PlanetxGear/KT0913_FM_Radio/LTSpice/Filter_003_WS001544.JPG

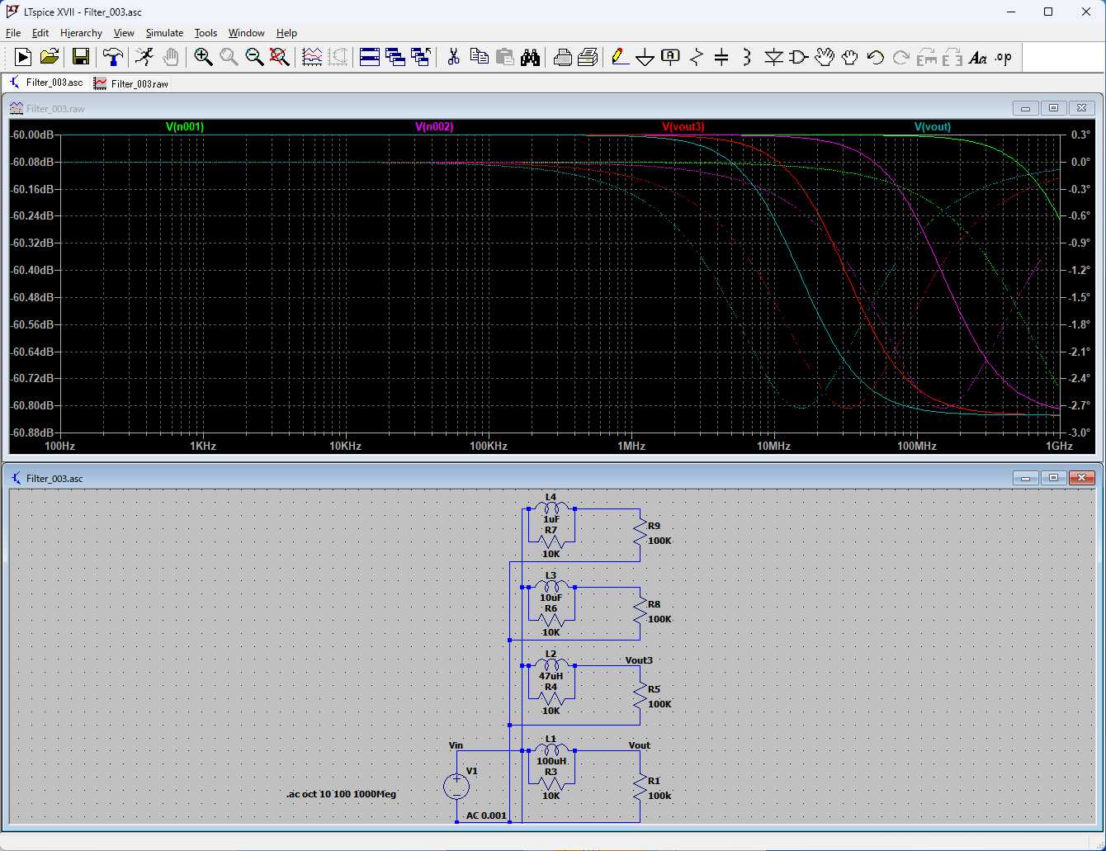
LTSpice/Filter_003_WS001544.JPG
