PlanetxGear/KT0913_FM_Radio/LTSpice/イヤホンアンテナ_LTSpice_WS001533.JPG

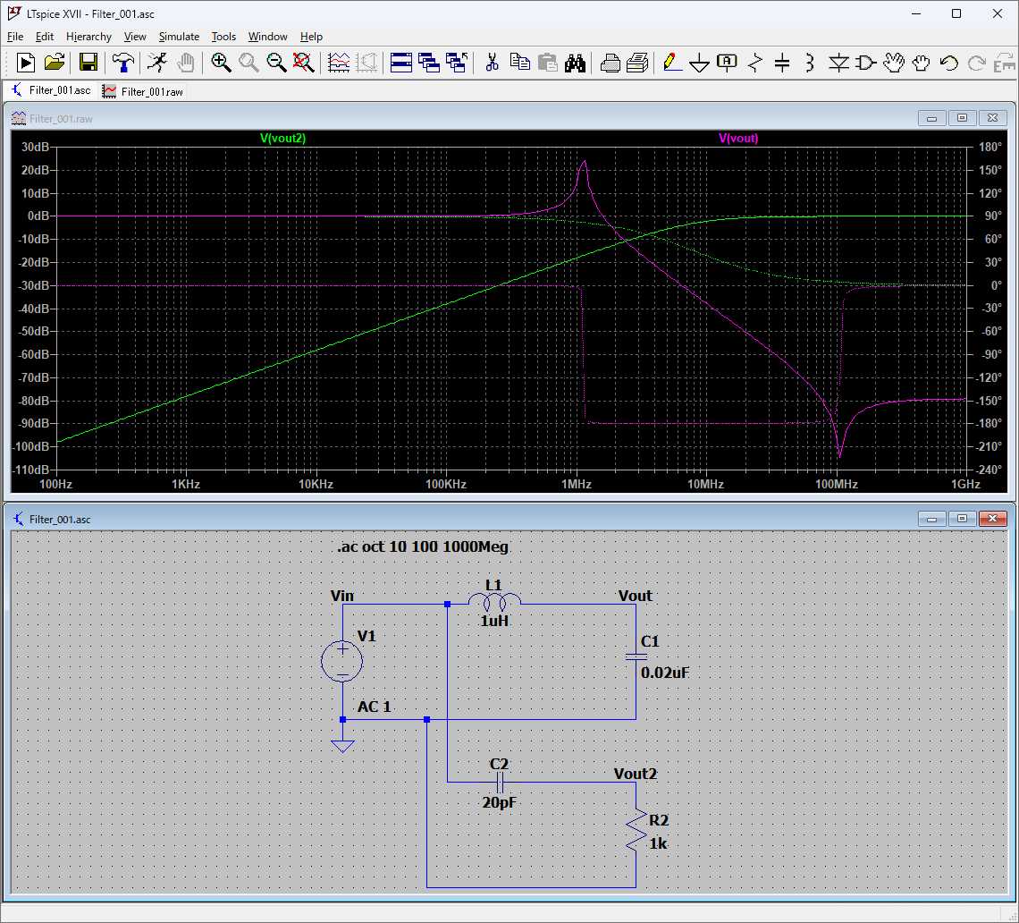
LTSpice/イヤホンアンテナ_LTSpice_WS001533.JPG
