PlanetxGear/KT0913_FM_Radio/PICクラブ発表資料_KT0913ラジオ_20240126.pdf

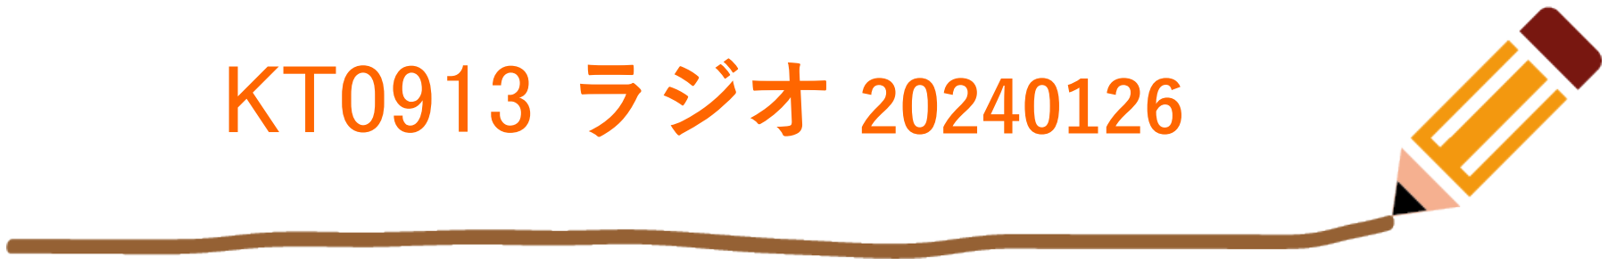
[picture p3: figure]
ラジオ 20240126

村上ひろし PlanetxGear
2024/01/26

KT0913 ラジオについて

- 2023年8月に後閑先生が発表されていた、DSP FM ラジオが面 白そうでしたので、自分でも作成してみました。
- KT0913は（株）秋月電子通商で購入できる、デジタルAM/FM ラジオICです。
– SDR方式のラジオ受信用IC
– FMは32～110MHz、AMは500～1710kHzに対応
– 16ピンSSOP, 0.635mmピッチ

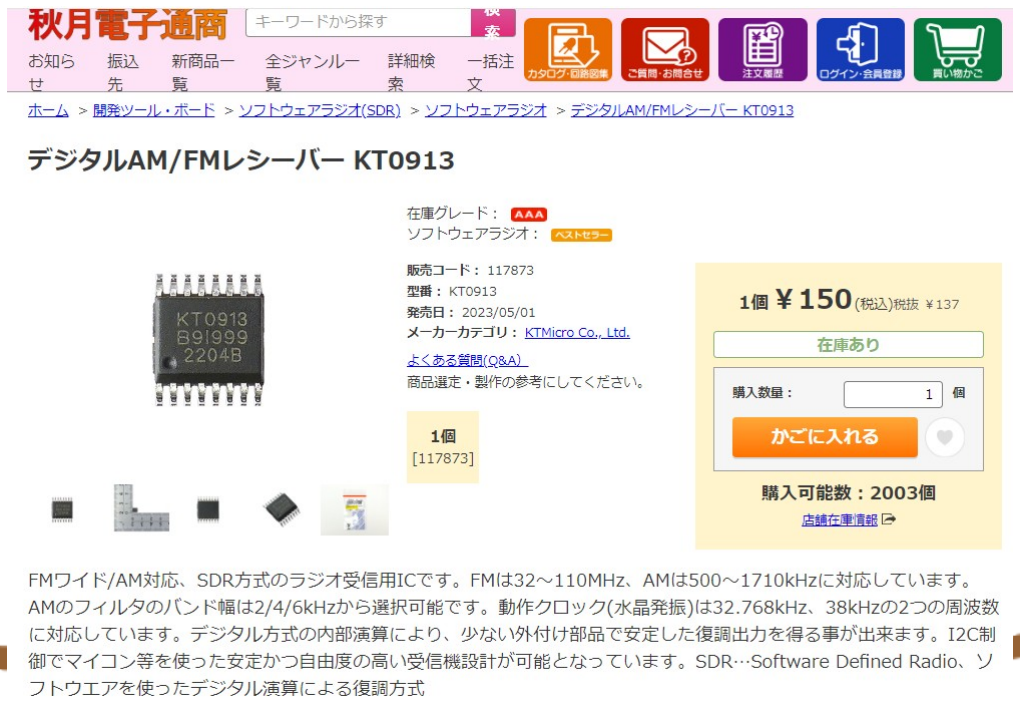
[picture p4: figure]

後閑先生のラジオの構成１

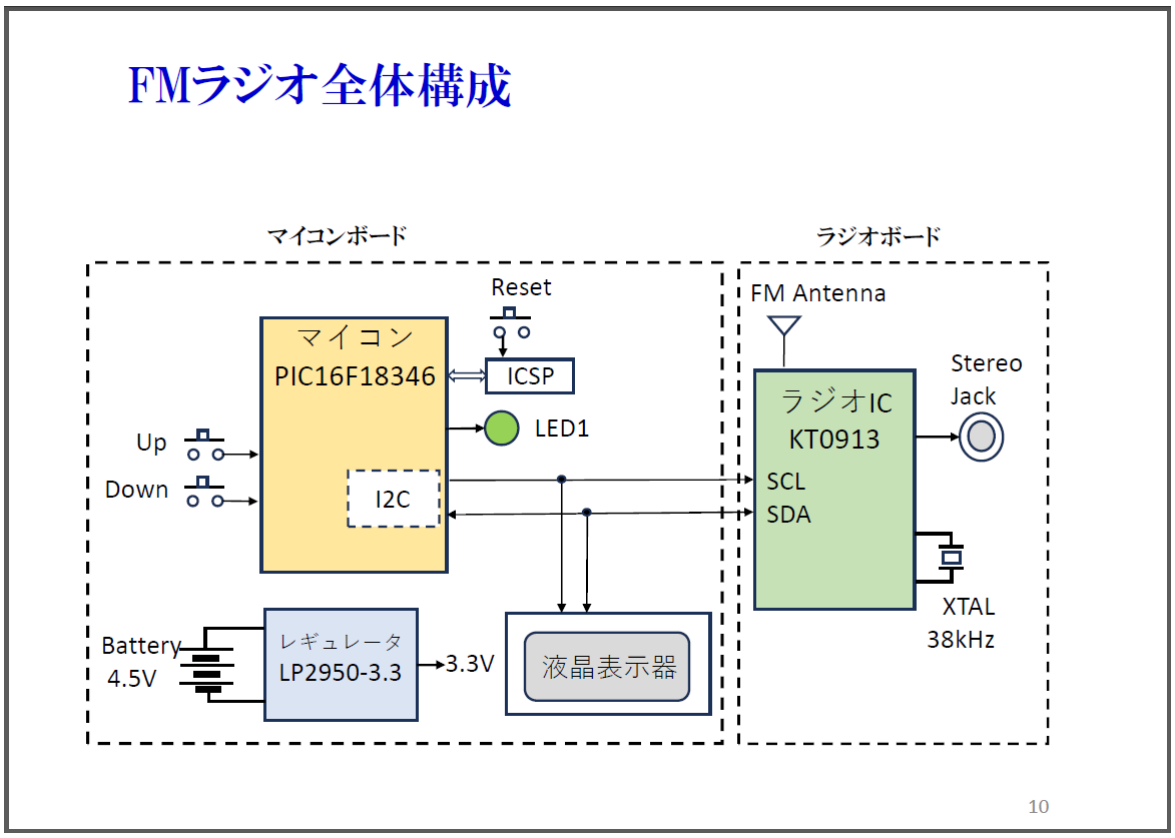
[picture p5: figure]

後閑先生のラジオの構成２

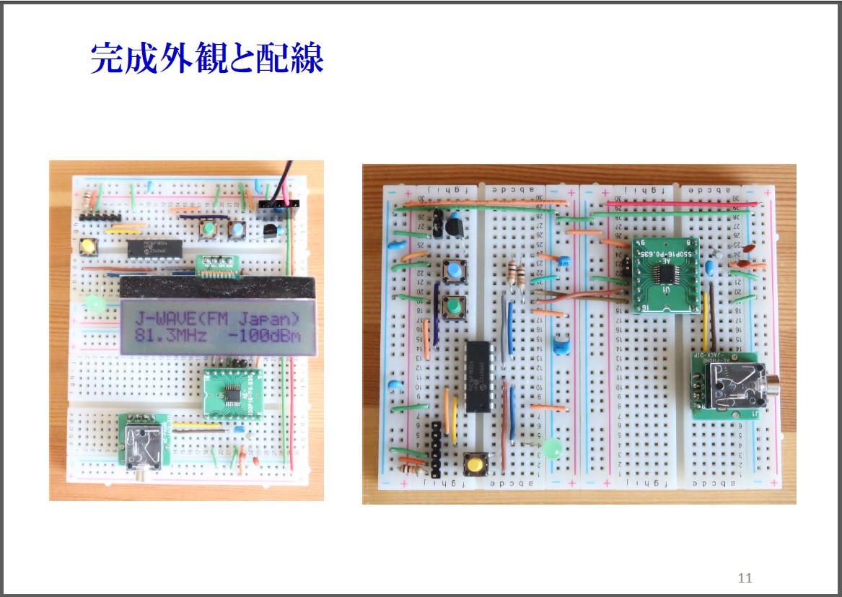
[picture p6: figure]
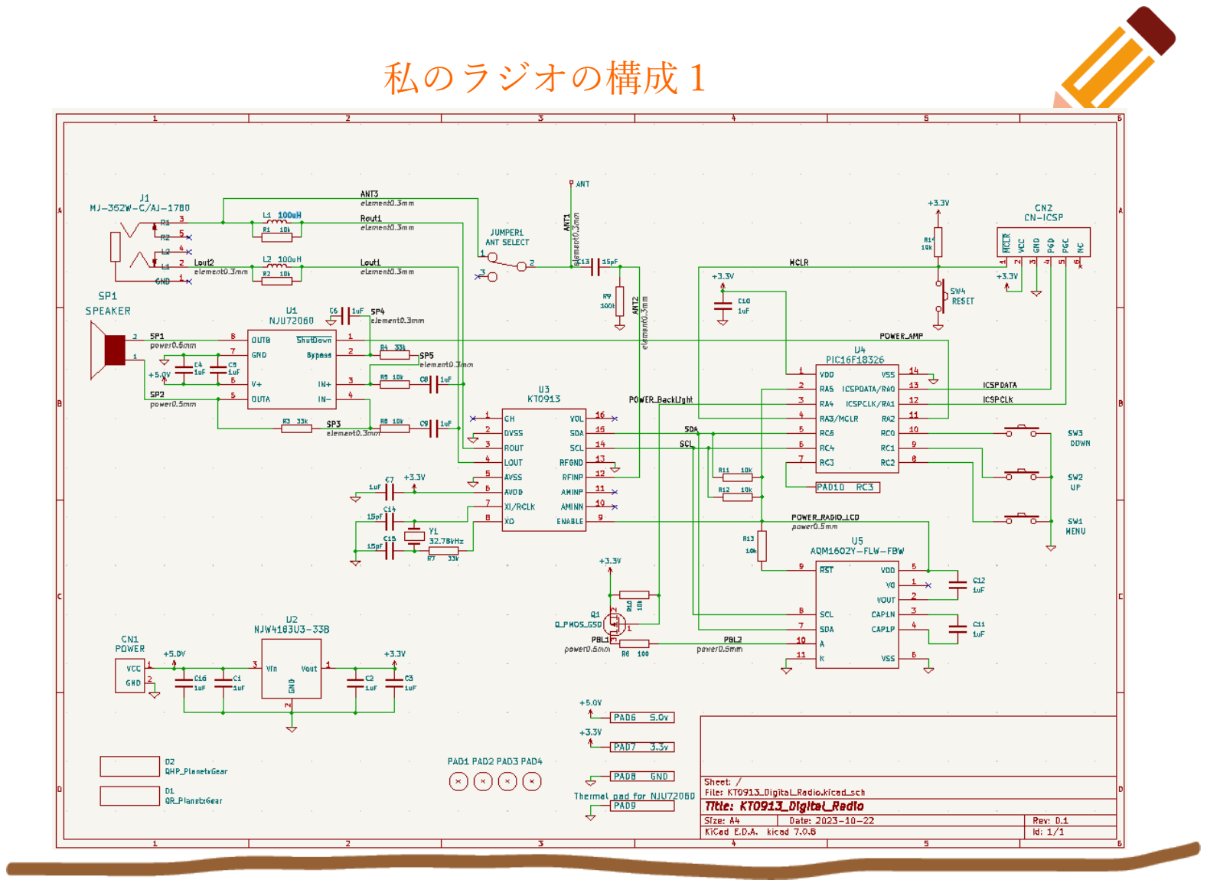
[picture p7: page 5]

私のラジオの構成１

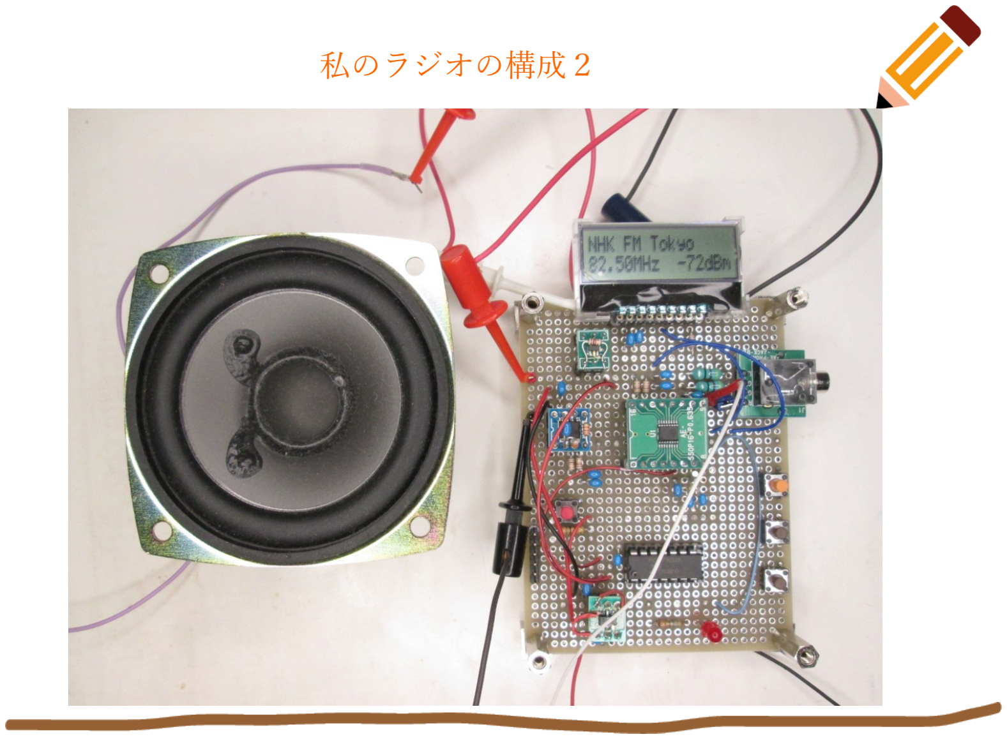
[picture p8: page 6]

私のラジオの構成２

ポイント１

- モノラル出力。
- ボリュームの調整はソフトウェア。*1~31段階
- 電源スチッチ代わりにスリープモードを搭載。*150μA
- イヤホンコードがアンテナ代わりに出来る。
– 渡辺さん、大江さんありがとうございます。

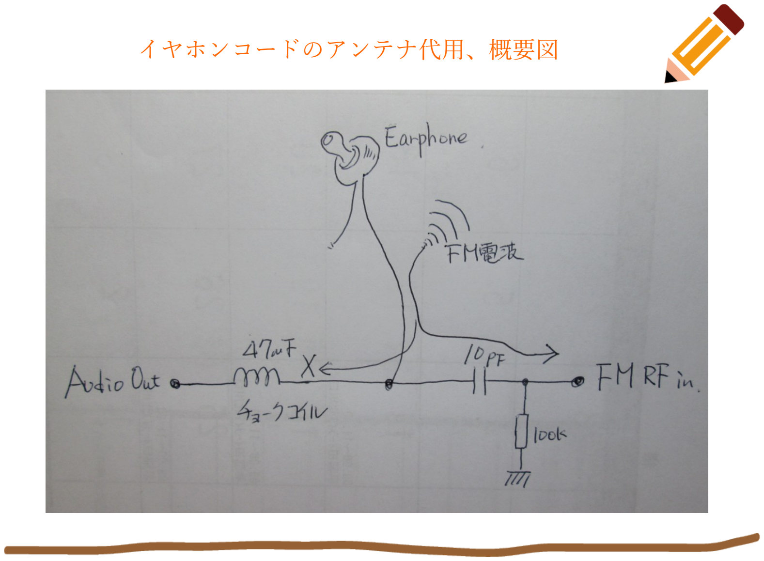
[picture p9: page 8]

イヤホンコードのアンテナ代用、概要図

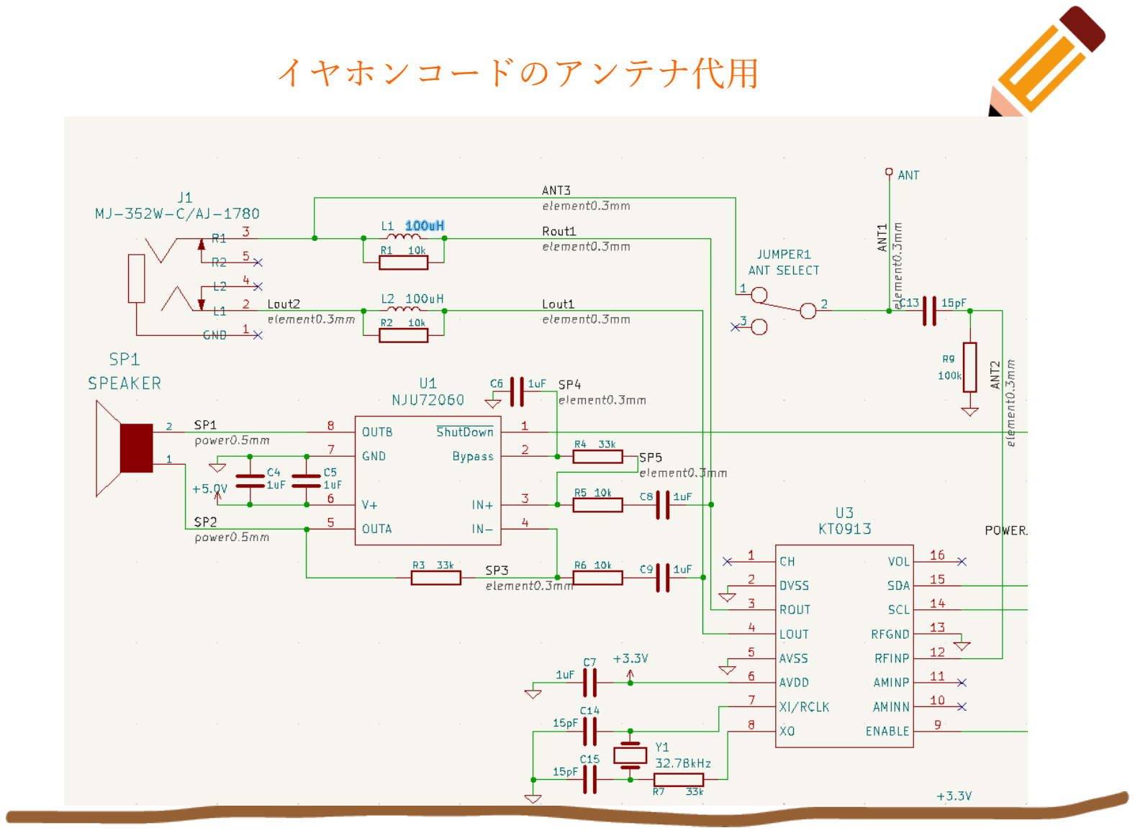
[picture p10: page 9]

イヤホンコードのアンテナ代用

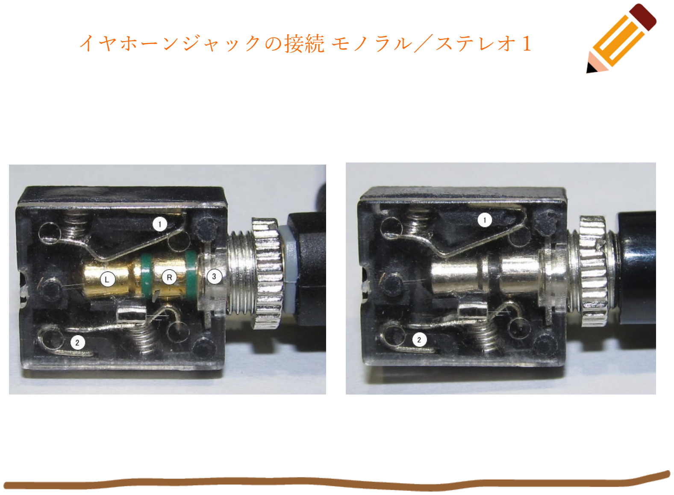
[picture p11: page 10]

イヤホーンジャックの接続 モノラル／ステレオ１

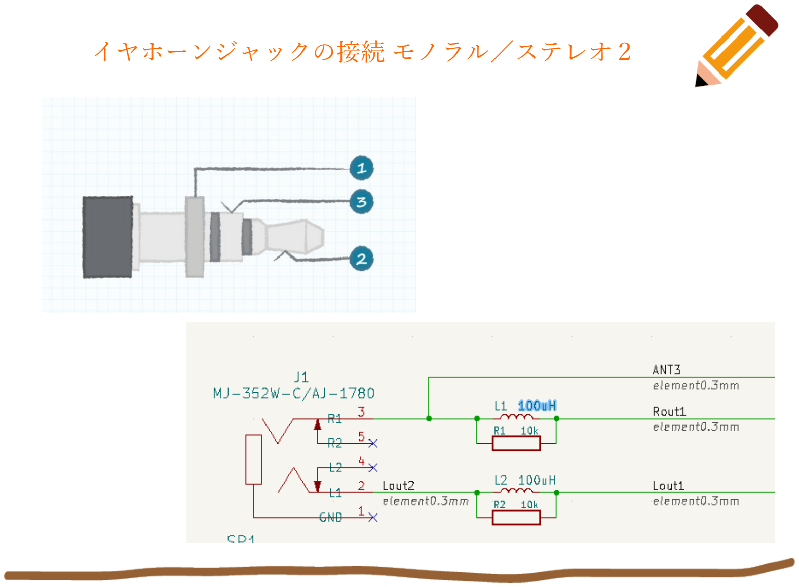
[picture p12: page 11]

イヤホーンジャックの接続 モノラル／ステレオ２

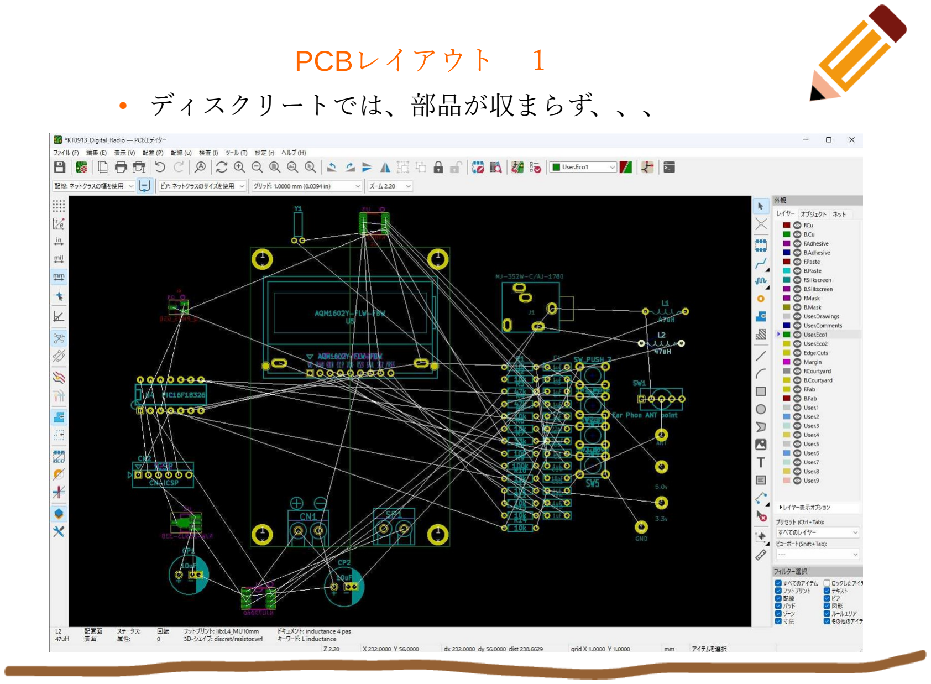
[picture p13: page 12]

PCBレイアウト　１
- ディスクリートでは、部品が収まらず、、、

PCBレイアウト　２
- 1608のチップ抵抗とチップコンデンサに変更して何とか収まりました。

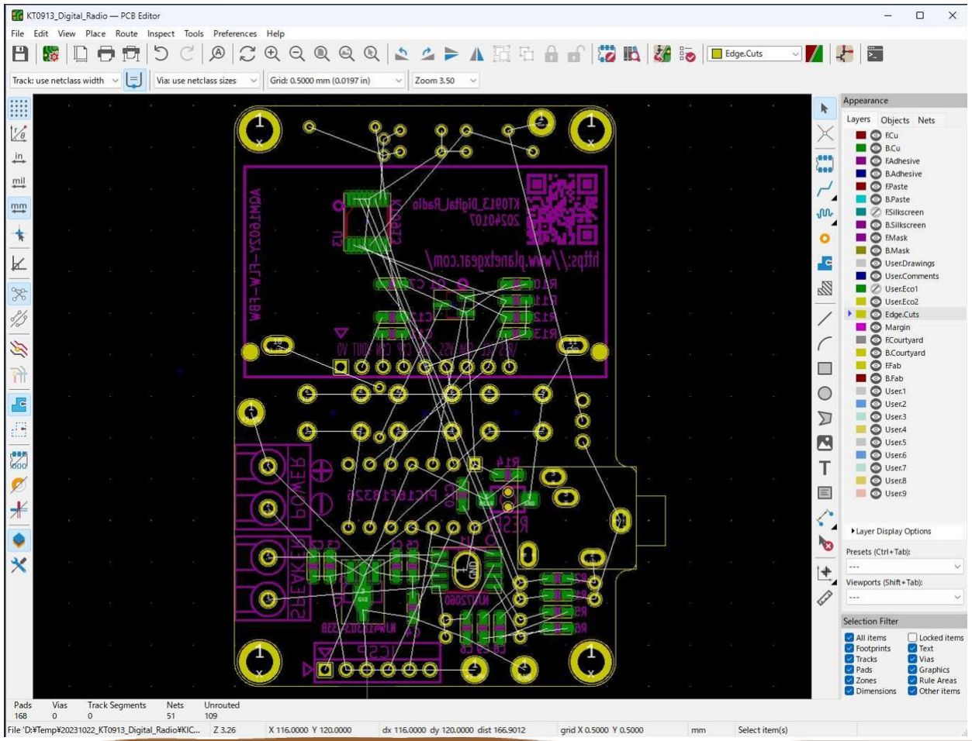
[picture p14: figure]

PCBレイアウト　３

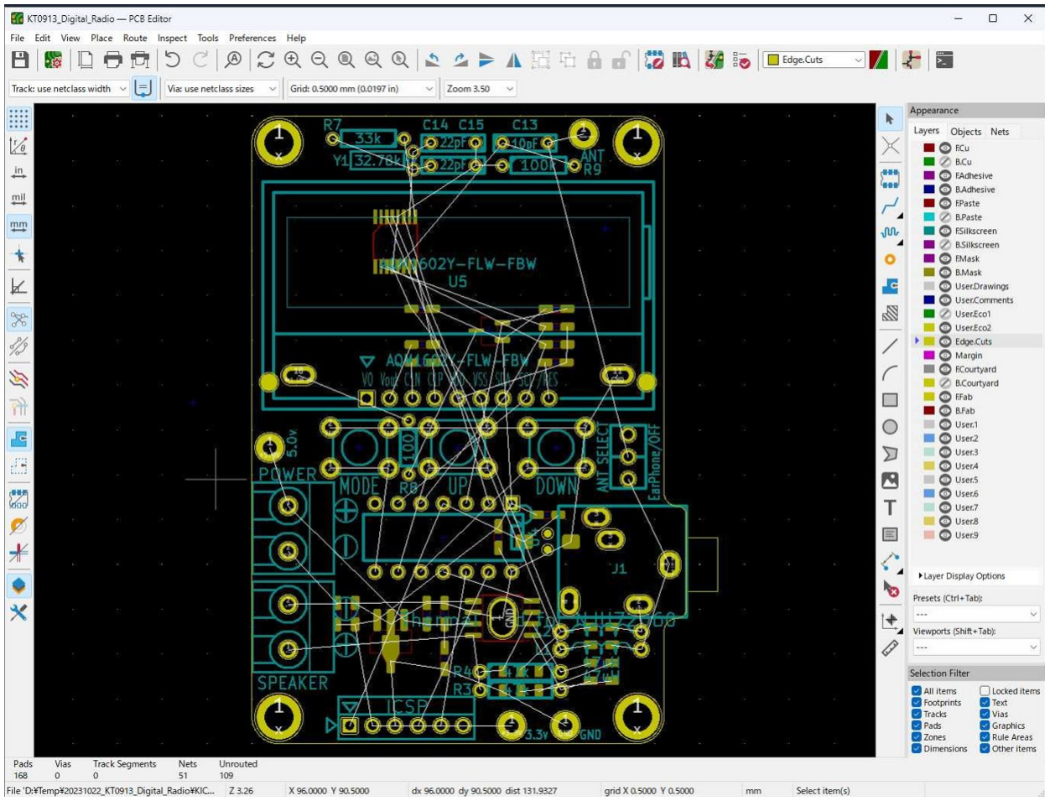
[picture p15: figure]

PCBレイアウト　３
- 今回自動配線は使わず、全て手配線で引きました。

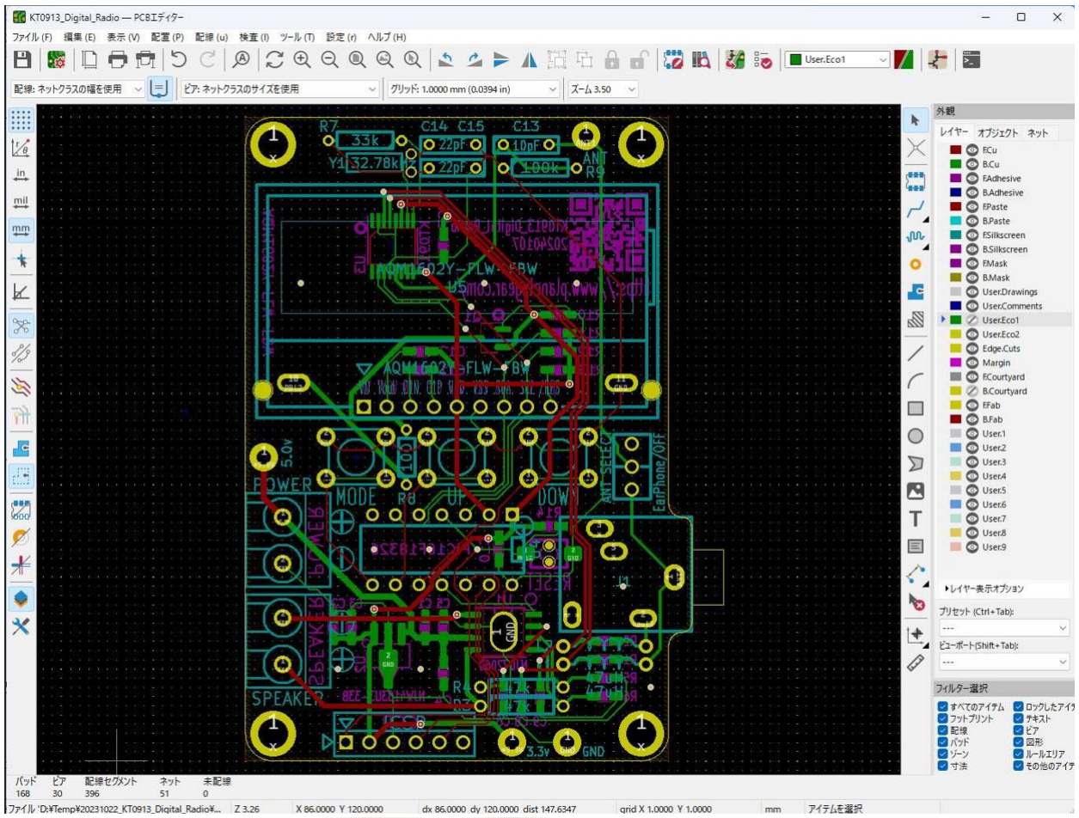
[picture p16: figure]
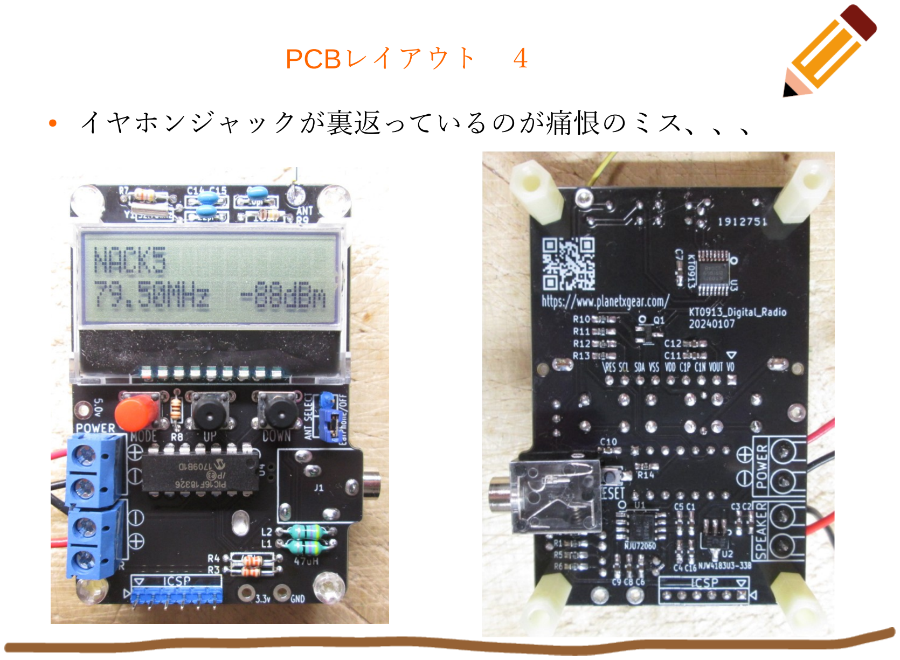
[picture p17: page 16]

PCBレイアウト　４

- イヤホンジャックが裏返っているのが痛恨のミス、、、

### Thank you!

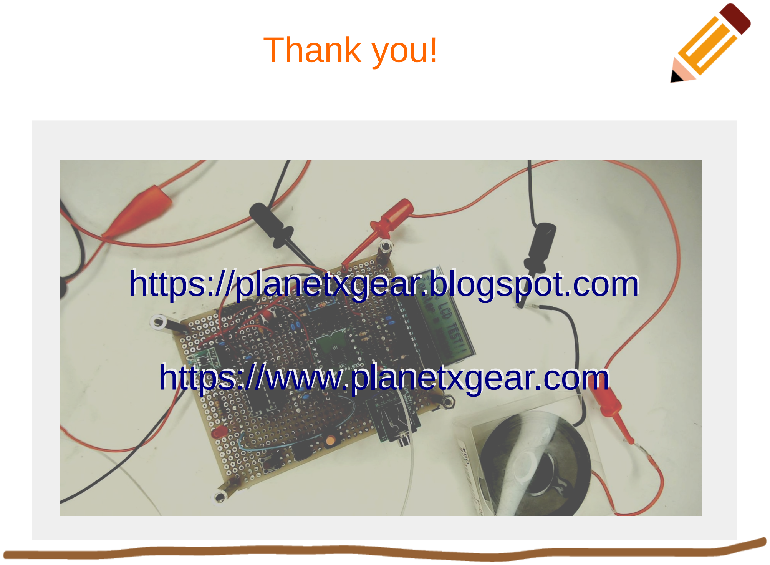
[picture p18: page 17]

### https://planetxgear.blogspot.com

### https://www.planetxgear.com
