PlanetxGear/KT0913_FM_Radio/LTSpice/1uH-0.1uF_WS001536.JPG

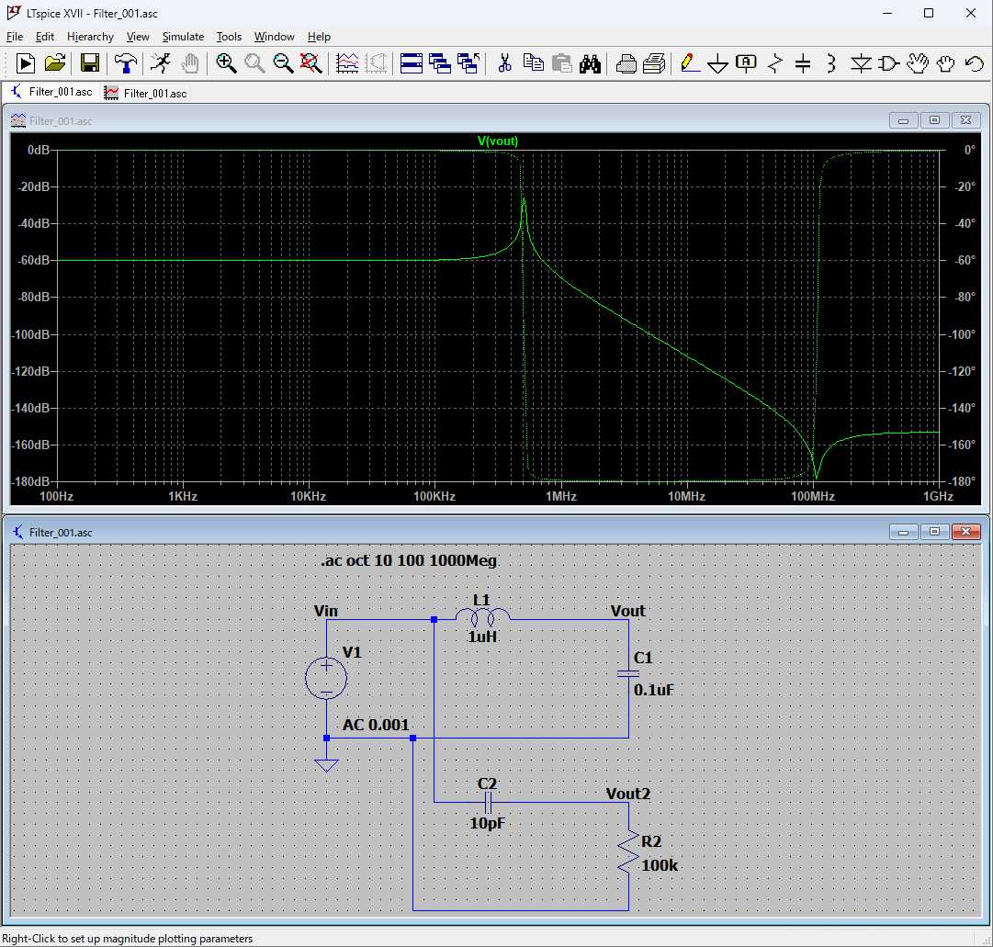
LTSpice/1uH-0.1uF_WS001536.JPG
