PlanetxGear/KT0913_FM_Radio/LTSpice/47uH-0.1uF_WS001534.JPG

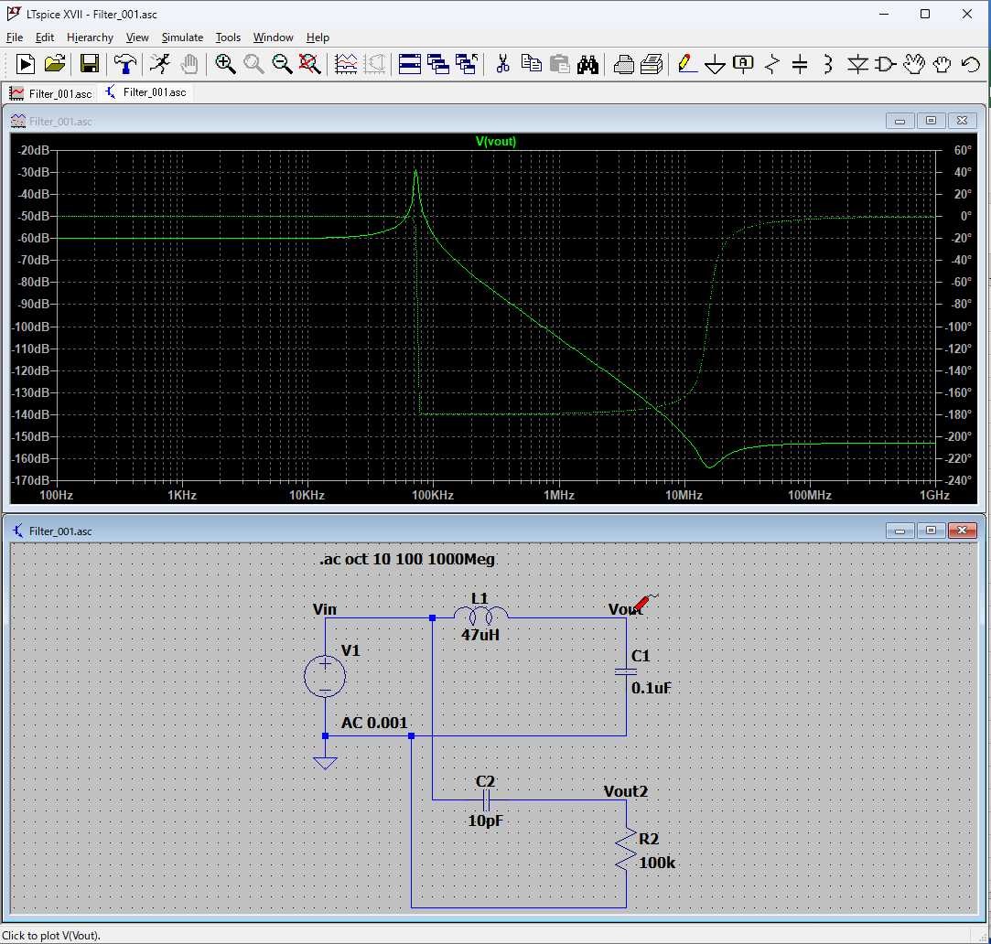
LTSpice/47uH-0.1uF_WS001534.JPG
