PlanetxGear/KT0913_FM_Radio/LTSpice/Filter_002_WS001537.JPG

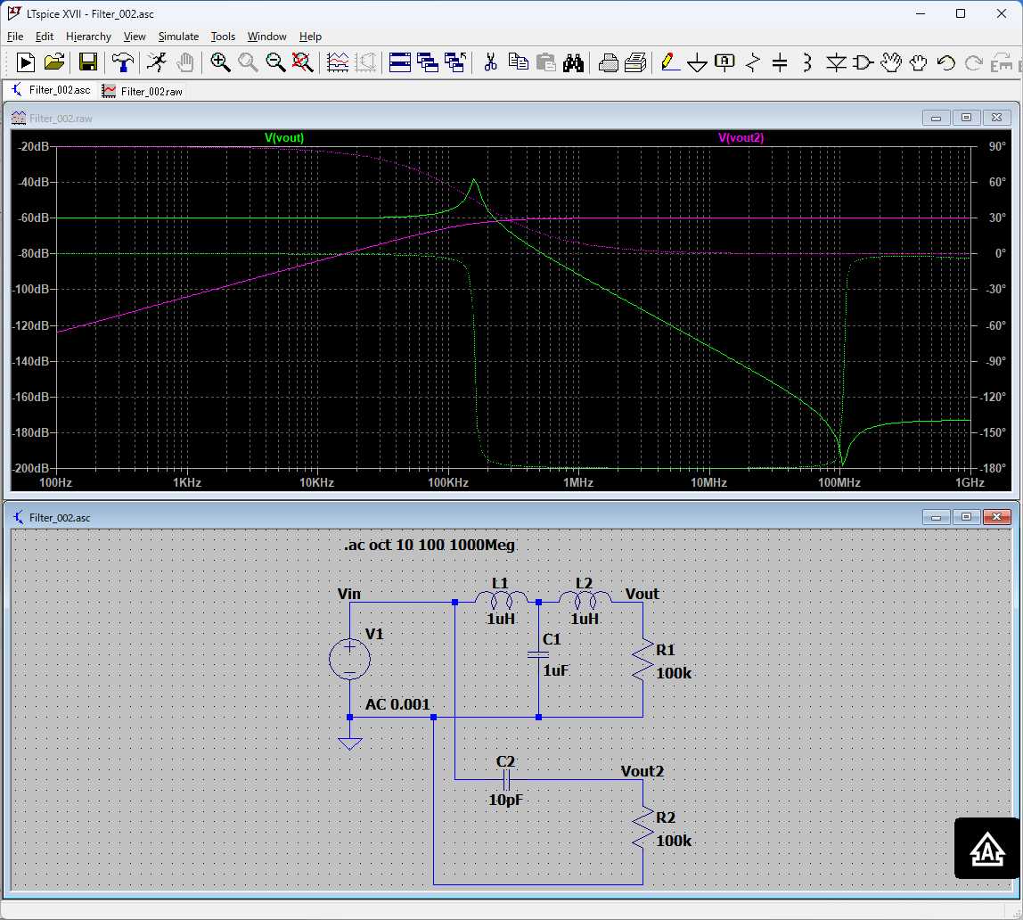
LTSpice/Filter_002_WS001537.JPG
