PlanetxGear/KT0913_FM_Radio/LTSpice/WS001540.JPG

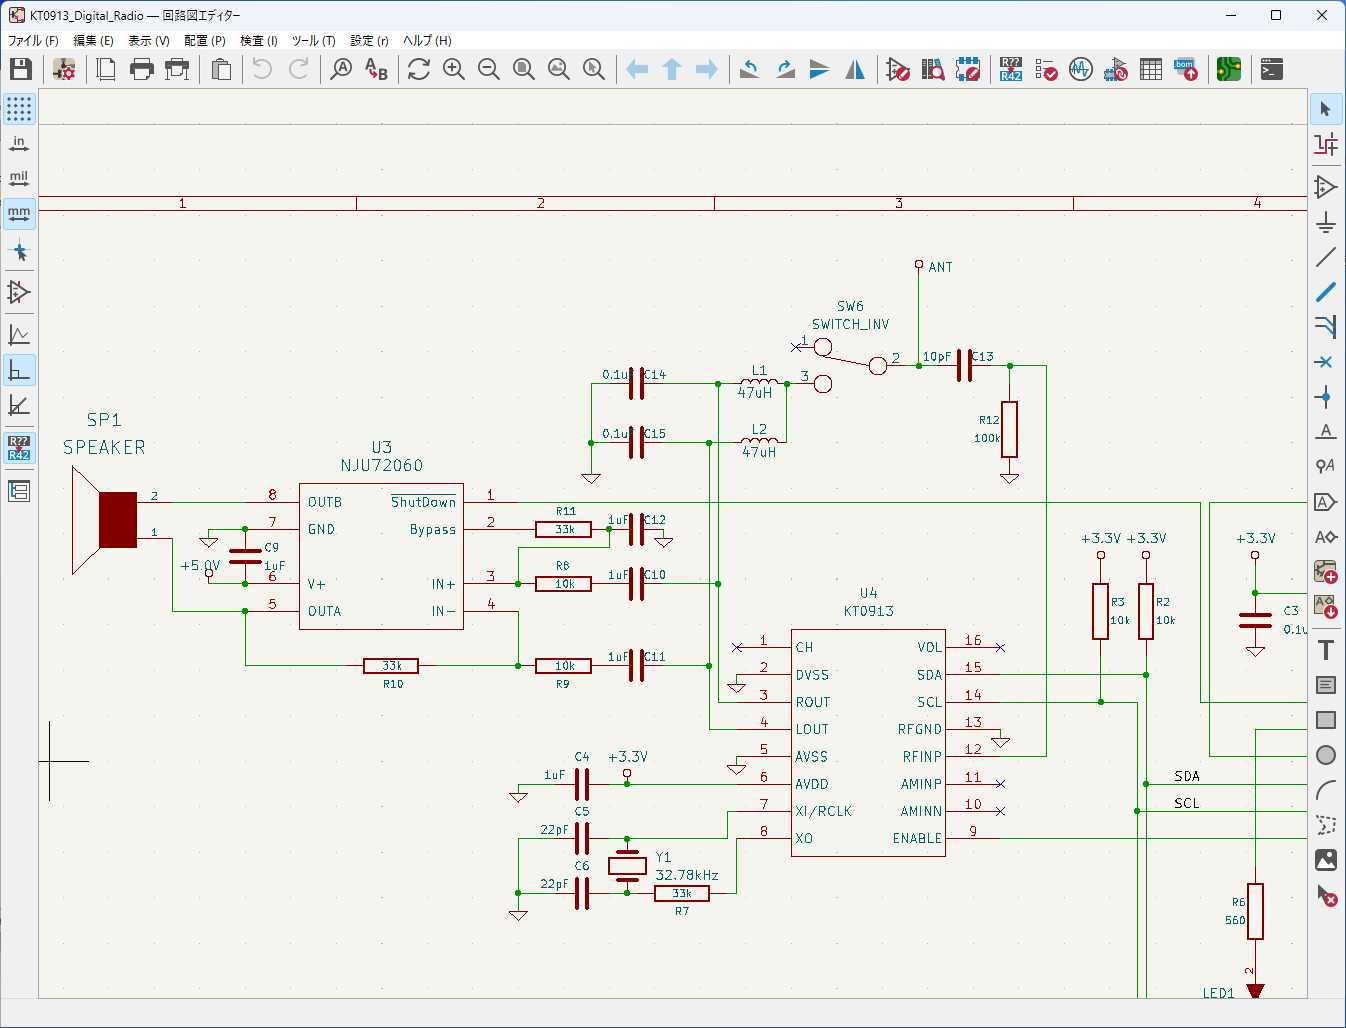
LTSpice/WS001540.JPG
