PlanetxGear/KT0913_FM_Radio/LTSpice/WS001541.JPG

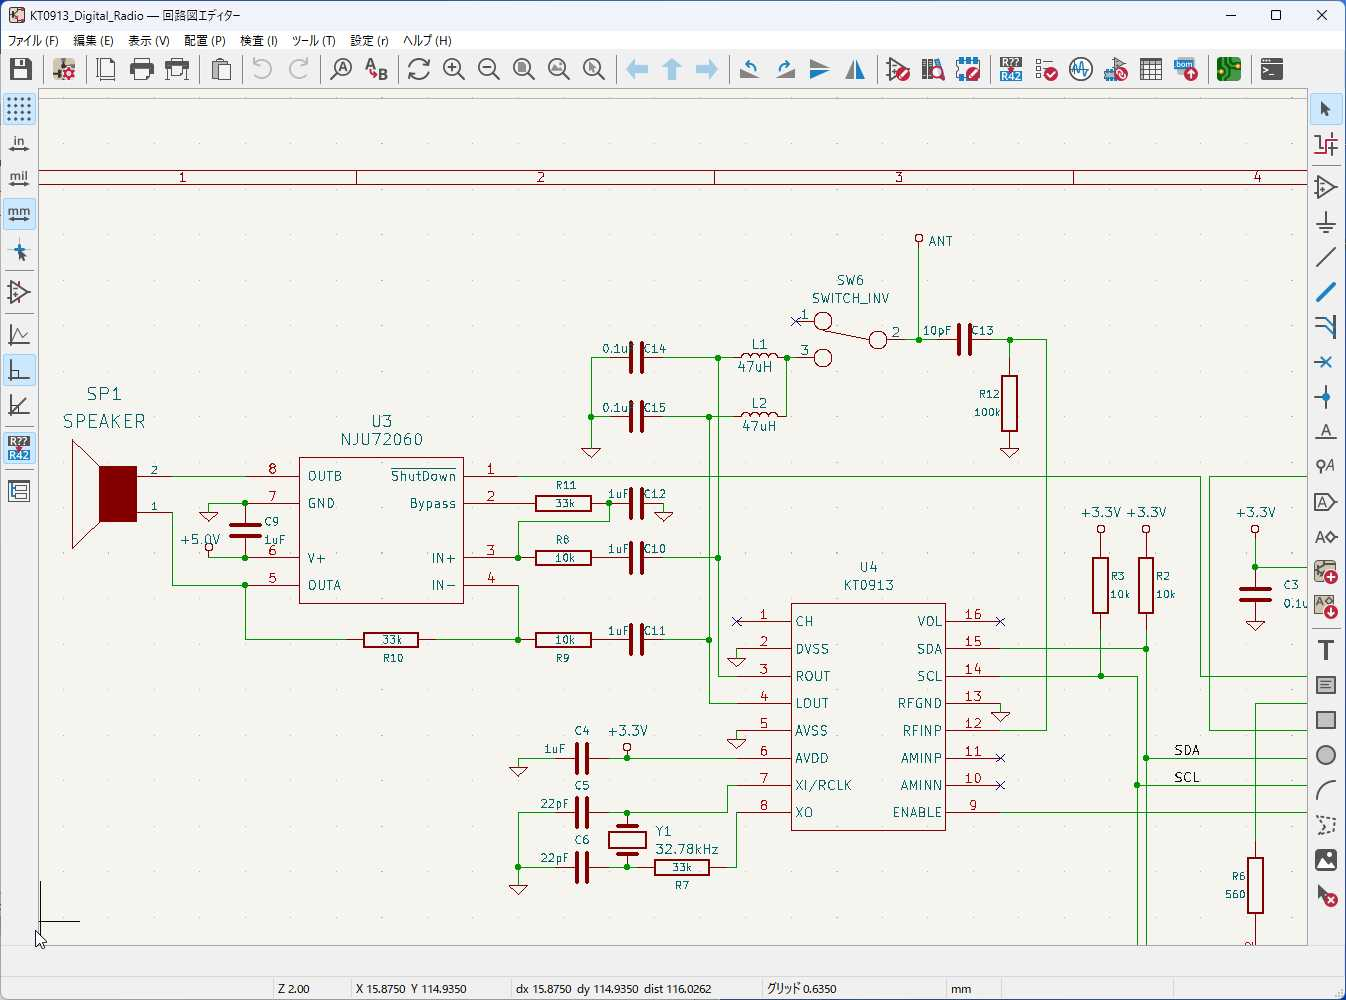
LTSpice/WS001541.JPG
