PlanetxGear/KT0913_FM_Radio/LTSpice/WS001542_修正前.JPG

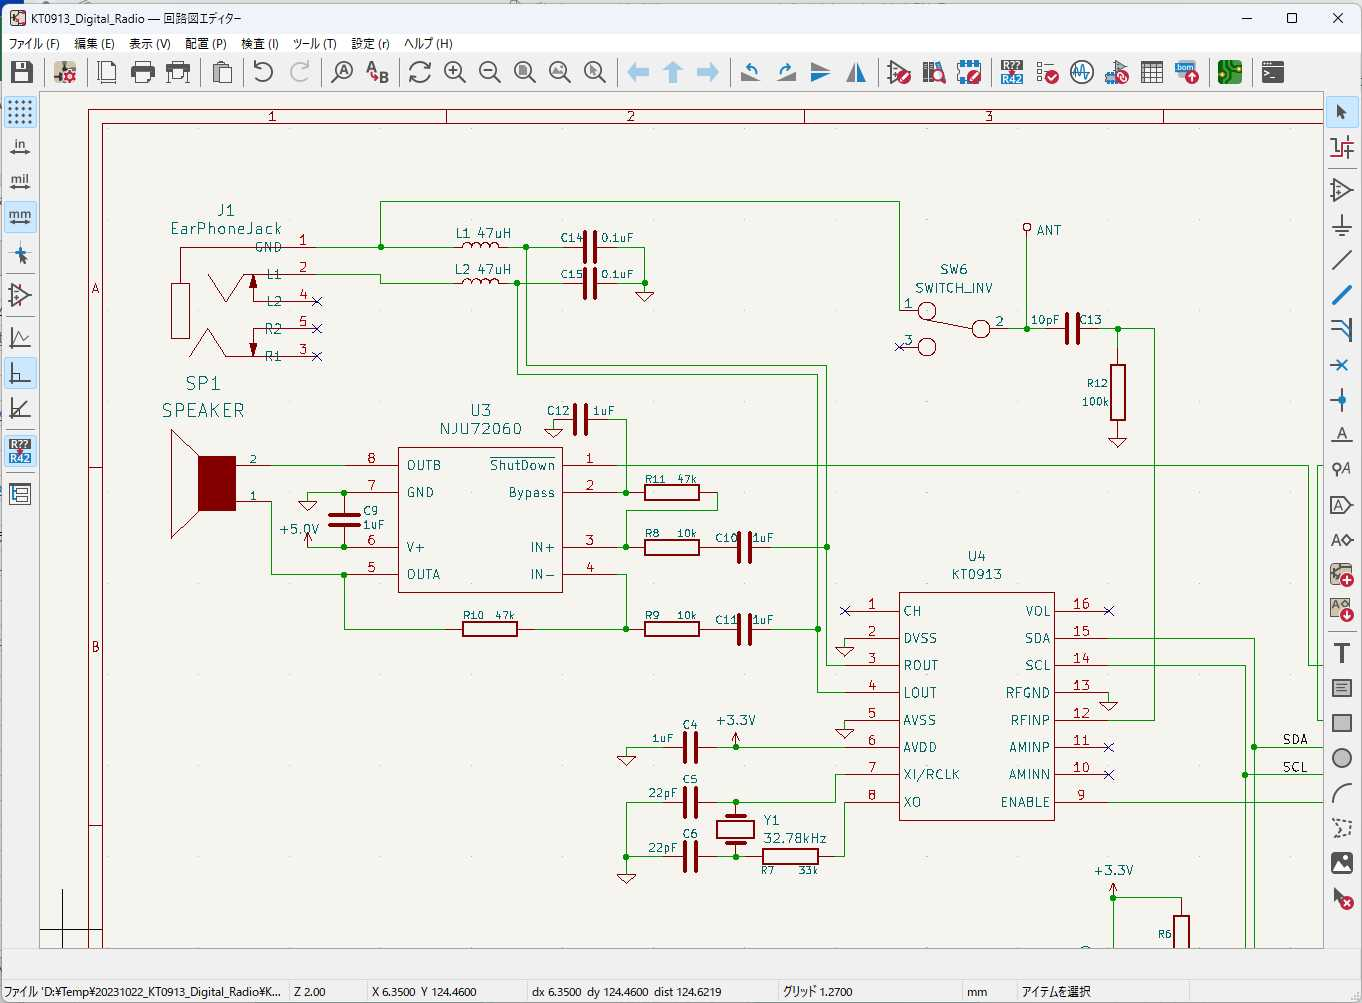
LTSpice/WS001542_修正前.JPG
