PlanetxGear/KT0913_FM_Radio/LTSpice/WS001543_修正後.JPG

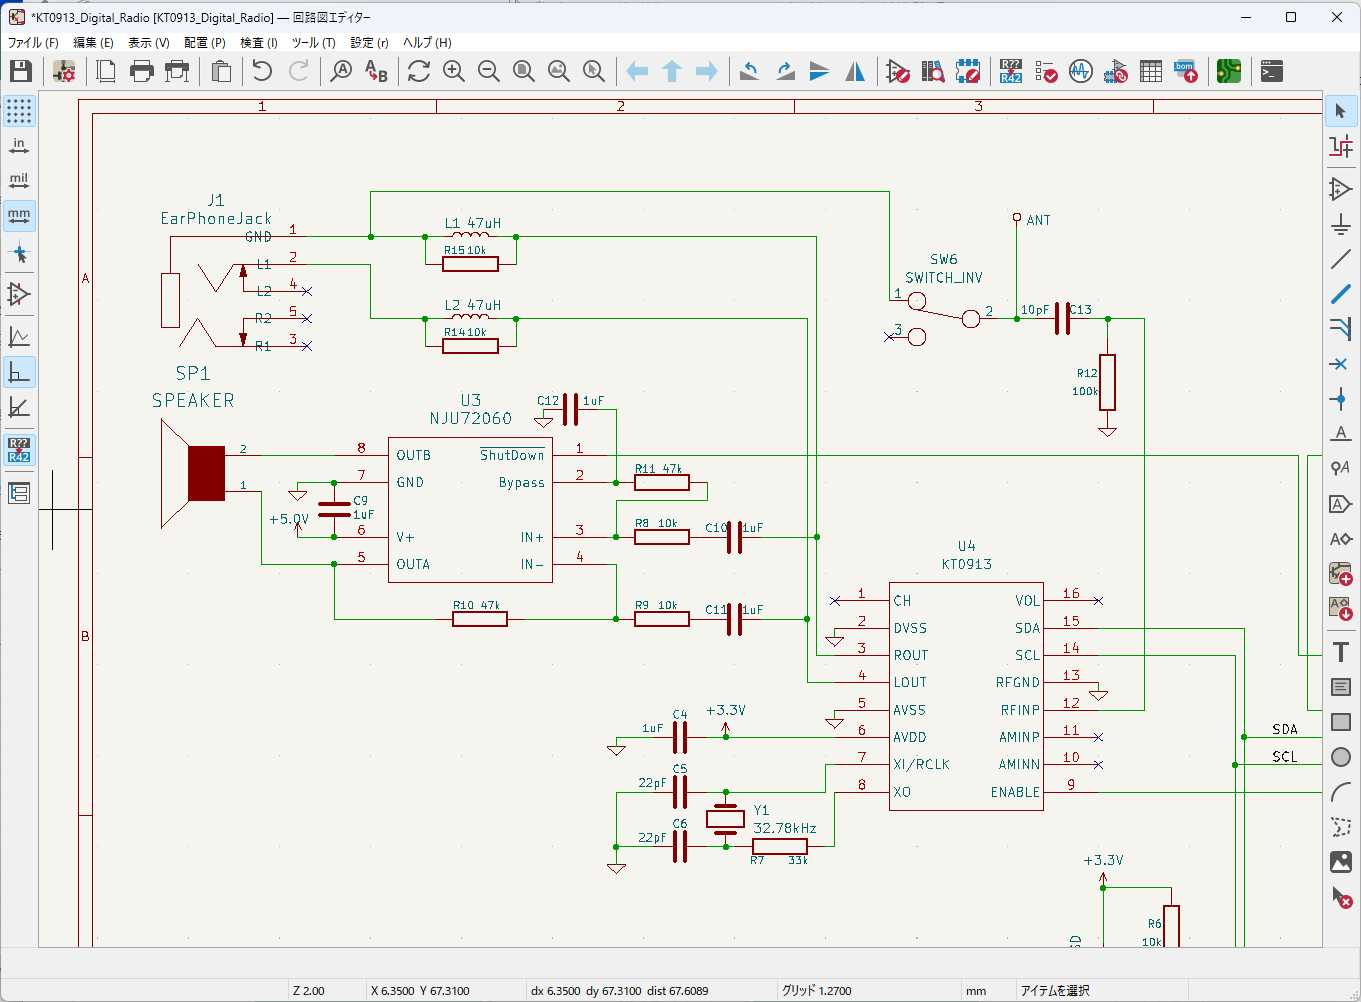
LTSpice/WS001543_修正後.JPG
