PlanetxGear/KT0913_FM_Radio/KICAD/KT0913_Digital_Radio/KT0913_Digital_Radio.xlsx

Sheet: KT0913_Digital_Radio
No. | Reference | Value | Footprint | 数量 |  |  |  |  |  |  |  | 入り数 | 単価 | 原価
1 | ANT1 | ANT | 1m~2m 電線 | - |  |  |  |  |  |  | ¥0
2 | C1-C12, C16 | 1uF | チップコンデンサ 0603/1608 | 13 | チップ積層セラミックコンデンサー 1μF25V X6S 1608 (https://akizukidenshi.com/catalog/g/g116993/) | 1uF | GRM188C81E105KA12 | 116993 | ¥120 | 1 | ¥120 | 40 | ¥3 | ¥39
3 | C13-C15 | 15pF | 積層セラミックコンデンサ | 3 | 積層セラミックコンデンサー 15pF50V C0G 5mm (https://akizukidenshi.com/catalog/g/g108092/) | 15pF | RDE5C1H150J0K1H03B | 108092 | ¥100 | 1 | ¥100 | 10 | ¥10 | ¥30
4 | CN1 | POWER | ターミナル 2端子 | 1 | ターミナルブロック 2P 青 縦 小 (https://akizukidenshi.com/catalog/g/g101306/) | 2端子 | TB111-2-2-U-1-1 | 101306 | ¥35 | 1 | ¥35 | 1 | ¥35 | ¥35
5 | CN2 | CN-ICSP | ピンヘッダ 6ピン | 1 | ピンヘッダ 1×6 (6P) (https://akizukidenshi.com/catalog/g/g101669/) | 6ピン | PH-1x6SG/RH | 101669 | ¥20 | 1 | ¥20 | 1 | ¥20 | ¥20
6 | D1 | HZU6.8GTRF-P-E | ツェナーダイオード | 1 | 定電圧ダイオード(ツェナーダイオード) 6.8V0.2W HZU6.8GTRF-P-E (https://akizukidenshi.com/catalog/g/g116839/) | 6.8v | HZU6.8GTRF-P-E | 116839 | ¥100 | 1 | ¥100 | 10 | ¥10 | ¥10
7 | J1 | MJ-352W-C/AJ-1780 | イヤホンジャック | 1 | 3.5mmステレオミニジャック スイッチ付き MJ-352W-C (https://akizukidenshi.com/catalog/g/g117359/) | イヤホンジャック | MJ-352W-C | 117359 | ¥90 | 1 | ¥90 | 10 | ¥9 | ¥9
8 | JUMPER1 | ANT SELECT | ピンヘッダ 3ピン | 1 | ピンヘッダ 1×3 (3P) (https://akizukidenshi.com/catalog/g/g103949/) | 3ピン | PH-1X3SG | 103949 | ¥30 | 1 | ¥30 | 10 | ¥3 | ¥3
9 | L1, L2 | 100uH | インダクター | 2 | マイクロインダクター １００μＨ （１０本入） (https://akizukidenshi.com/catalog/g/g103966/) | 100uH | AL0307-101K | 103966 | ¥70 | 1 | ¥70 | 10 | ¥7 | ¥14
10 | L3 | 100uH | インダクター | 1 | マイクロインダクター １００μＨ （１０本入） (https://akizukidenshi.com/catalog/g/g110685/) | 100uH | AL0410-101K | 110685 | ¥80 | 1 | ¥80 | 10 | ¥8 | ¥8
11 | O1 | QR_PlanetxGear | - | - |  |  |  |  |  |  | ¥0
12 | O2 | QHP_PlanetxGear | - | - |  |  |  |  |  |  | ¥0
13 | PAD1-PAD4 | PAD | - | - |  |  |  |  |  |  | ¥0
14 | PAD5 | RC1 | - | - |  |  |  |  |  |  | ¥0
15 | PAD6 | 5.0v | - | - |  |  |  |  |  |  | ¥0
16 | PAD7 | 3.3v | - | - |  |  |  |  |  |  | ¥0
17 | PAD8 | GND | - | - |  |  |  |  |  |  | ¥0
18 | PAD10 | RC3 | - | - |  |  |  |  |  |  | ¥0
19 | Q1, Q2 | SSM3J332RLF | Pch MOS FET | 2 | PchMOSFET SSM3J332R (https://akizukidenshi.com/catalog/g/g115985/) | PchFET | SSM3J332RLF | 115985 | ¥120 | 1 | ¥120 | 10 | ¥12 | ¥24
20 | R1, R2, R5, R6, R10-R14 | 10kΩ | チップ抵抗 0603/1608 | 9 | チップ抵抗 1/10W10kΩ (https://akizukidenshi.com/catalog/g/g115029/) | 10kΩ | RC0603J10K | 115029 | ¥980 | 1 | ¥980 | 5000 | ¥1 | ¥9
21 | R3, R4, R7 | 33kΩ | カーボン抵抗 1/6w | 3 | カーボン抵抗(炭素皮膜抵抗) 1/6W33kΩ (https://akizukidenshi.com/catalog/g/g116333/) | 33kΩ | CF16J33KB | 116333 | ¥100 | 1 | ¥100 | 100 | ¥1 | ¥3
22 | R8 | 100Ω | カーボン抵抗 1/6w | 1 | カーボン抵抗(炭素皮膜抵抗) 1/6W100Ω (https://akizukidenshi.com/catalog/g/g116101/) | 100Ω | CF16J100RB | 116101 | ¥120 | 1 | ¥120 | 100 | ¥2 | ¥2
23 | R9 | 100kΩ | カーボン抵抗 1/6w | 1 | カーボン抵抗(炭素皮膜抵抗) 1/6W100kΩ (https://akizukidenshi.com/catalog/g/g116104/) | 100kΩ | RD16S 100K | 116104 | ¥100 | 1 | ¥100 | 100 | ¥1 | ¥1
24 | SP1 | SPEAKER | ターミナル 2端子 | 1 | ターミナルブロック 2P 青 縦 小 (https://akizukidenshi.com/catalog/g/g101306/) | 2端子 | TB111-2-2-U-1-1 | 101306 | ¥35 | 1 | ¥35 | 1 | ¥35 | ¥35
25 | SW1 | MENU | タクトスイッチ赤 | 1 | タクトスイッチ TVDP01-G73BB(赤) (https://akizukidenshi.com/catalog/g/g109825/) | Switch | TVDP01-G73BB with Red cap | 109825 | ¥20 | 1 | ¥20 | 1 | ¥20 | ¥20
26 | SW2 | UP | タクトスイッチ黒 | 1 | タクトスイッチ TVDP01-G73BB(黒) (https://akizukidenshi.com/catalog/g/g109824/) | Switch | TVDP01-G73BB with Black cap | 109824 | ¥20 | 1 | ¥20 | 1 | ¥20 | ¥20
27 | SW3 | DOWN | タクトスイッチ黒 | 1 | タクトスイッチ TVDP01-G73BB(黒) (https://akizukidenshi.com/catalog/g/g109824/) | Switch | TVDP01-G73BB with Black cap | 109824 | ¥20 | 1 | ¥20 | 1 | ¥20 | ¥20
28 | SW4 | RESET | 表面実装タクトスイッチ | 1 | 表面実装用タクトスイッチ TVAF06-A020B-R (https://akizukidenshi.com/catalog/g/g114888/) | Switch | TVAF06-A020B-R | 114888 | ¥110 | 1 | ¥110 | 5 | ¥22 | ¥22
29 | U1 | NJU72060 | オーディオアンプ | 1 | オーディオアンプIC NJU72060GM1T (https://akizukidenshi.com/catalog/g/g114330/) | Amp | NJU72060GM1T | 114330 | ¥90 | 1 | ¥90 | 1 | ¥90 | ¥90
30 | U2 | NJW4183U3-33B | レギュレータ 3.3v | 1 | 低損失レギュレーター 3.3V100mA NJW4183U3-33B (https://akizukidenshi.com/catalog/g/g113853/) | レギュレータ | NJW4183U3-33B | 113853 | ¥250 | 1 | ¥250 | 4 | ¥63 | ¥63
31 | U3 | KT0913 | ラジオIC | 1 | デジタルAM/FMレシーバー KT0913 (https://akizukidenshi.com/catalog/g/g117873/) | ラジオIC | KT0913 | 117873 | ¥150 | 1 | ¥150 | 1 | ¥150 | ¥150
32 | U4 | PIC16F18326 | PIC 14ピン | 1 | PICマイコン PIC16F18326-I/P (https://akizukidenshi.com/catalog/g/g111886/) | PIC | PIC16F18326-I/P | 111886 | ¥250 | 1 | ¥250 | 1 | ¥250 | ¥250
33 | U5 | AQM1602Y-FLW-FBW | LCDディスプレイ 16文字×2行 | 1 | LCDモジュール 16×2行 白色バックライト付 AQM1602Y-FLW-FBW (https://akizukidenshi.com/catalog/g/g112619/) | LCD | AQM1602Y-FLW-FBW | 112619 | ¥780 | 1 | ¥780 | 1 | ¥780 | ¥780
34 | Y1 | 32.78kHz | クリスタル VT200 | 1 | クリスタル(水晶発振子) 32.768kHz (https://akizukidenshi.com/catalog/g/g104005/) | クリスタル | VT-200-F 32.768kHz | 104005 | ¥30 | 1 | ¥30 | 1 | ¥30 | ¥30
35 |  | ジャンパーピン青(2.54mmピッチ) | ジャンパーピン青(2.54mmピッチ) | 1 | ジャンパーピン青(2.54mmピッチ) (https://akizukidenshi.com/catalog/g/g103690/) | ジャンパーピン | MJ-254-6BU | 103690 | ¥100 | 1 | ¥100 | 25 | ¥4 | ¥4
36 |  | SPEAKER | スピーカー 5cm | 1 | スピーカーユニット 5cm 8Ω0.5W (https://akizukidenshi.com/catalog/g/g116024/) | 8Ω 0.5w | DXYD50N-22Z-8A-F | 116024 | ¥180 | 1 | ¥180 | 1 | ¥180 | ¥180
37 |  | BATTERY | 電池ボックス 単3×4本 | 1 | 電池ボックス 単3×4本 リード線 (https://akizukidenshi.com/catalog/g/g102671/) | 電池ボックス | BH-341-2A150MM | 102671 | ¥80 | 1 | ¥80 | 1 | ¥80 | ¥80
38 |  | 基板 | 基板 | 1 | プリント基板 |  |  |  | ¥500 | 1 | ¥500 | 1 | ¥500 | ¥500
 |  |  |  |  |  |  |  |  |  |  |  |  | 合計 | ¥2451

Sheet: KT0913_Digital_Radio (2)
No. | Reference | Value | Footprint | 数量 |  |  |  |  |  |  |  | 入り数 | 単価 | 原価
1 | ANT1 | ANT | 1m~2m 電線 | - |  |  |  |  |  |  | ¥0
2 | C1-C12, C16 | 1uF | チップコンデンサ 0603/1608 | 13 | チップ積層セラミックコンデンサー 1μF25V X6S 1608 (https://akizukidenshi.com/catalog/g/g116993/) | 1uF | GRM188C81E105KA12 | 116993 | ¥120 | 1 | ¥120 | 40 | ¥3 | ¥39
3 | C13-C15 | 15pF | 積層セラミックコンデンサ | 3 | 積層セラミックコンデンサー 15pF50V C0G 5mm (https://akizukidenshi.com/catalog/g/g108092/) | 15pF | RDE5C1H150J0K1H03B | 108092 | ¥100 | 1 | ¥100 | 10 | ¥10 | ¥30
4 | CN1 | POWER | ターミナル 2端子 | 1 | ターミナルブロック 2P 青 縦 小 (https://akizukidenshi.com/catalog/g/g101306/) | 2端子 | TB111-2-2-U-1-1 | 101306 | ¥35 | 1 | ¥35 | 1 | ¥35 | ¥35
5 | CN2 | CN-ICSP | ピンヘッダ 6ピン | 1 | ピンヘッダ 1×6 (6P) (https://akizukidenshi.com/catalog/g/g101669/) | 6ピン | PH-1x6SG/RH | 101669 | ¥20 | 1 | ¥20 | 1 | ¥20 | ¥20
6 | D1 | HZU6.8GTRF-P-E | ツェナーダイオード | 1 | 定電圧ダイオード(ツェナーダイオード) 6.8V0.2W HZU6.8GTRF-P-E (https://akizukidenshi.com/catalog/g/g116839/) | 6.8v | HZU6.8GTRF-P-E | 116839 | ¥100 | 1 | ¥100 | 10 | ¥10 | ¥10
7 | J1 | MJ-352W-C/AJ-1780 | イヤホンジャック | 1 | 3.5mmステレオミニジャック スイッチ付き MJ-352W-C (https://akizukidenshi.com/catalog/g/g117359/) | イヤホンジャック | MJ-352W-C | 117359 | ¥90 | 1 | ¥90 | 10 | ¥9 | ¥9
8 | JUMPER1 | ANT SELECT | ピンヘッダ 3ピン | 1 | ピンヘッダ 1×3 (3P) (https://akizukidenshi.com/catalog/g/g103949/) | 3ピン | PH-1X3SG | 103949 | ¥30 | 1 | ¥30 | 10 | ¥3 | ¥3
9 | L1, L2 | 100uH | インダクター | 2 | マイクロインダクター １００μＨ （１０本入） (https://akizukidenshi.com/catalog/g/g103966/) | 100uH | AL0307-101K | 103966 | ¥70 | 1 | ¥70 | 10 | ¥7 | ¥14
10 | L3 | 100uH | インダクター | 1 | マイクロインダクター １００μＨ （１０本入） (https://akizukidenshi.com/catalog/g/g110685/) | 100uH | AL0410-101K | 110685 | ¥80 | 1 | ¥80 | 10 | ¥8 | ¥8
11 | O1 | QR_PlanetxGear | - | - |  |  |  |  |  |  | ¥0
12 | O2 | QHP_PlanetxGear | - | - |  |  |  |  |  |  | ¥0
13 | PAD1-PAD4 | PAD | - | - |  |  |  |  |  |  | ¥0
14 | PAD5 | RC1 | - | - |  |  |  |  |  |  | ¥0
15 | PAD6 | 5.0v | - | - |  |  |  |  |  |  | ¥0
16 | PAD7 | 3.3v | - | - |  |  |  |  |  |  | ¥0
17 | PAD8 | GND | - | - |  |  |  |  |  |  | ¥0
18 | PAD10 | RC3 | - | - |  |  |  |  |  |  | ¥0
19 | Q1, Q2 | SSM3J332RLF | Pch MOS FET | 2 | PchMOSFET SSM3J332R (https://akizukidenshi.com/catalog/g/g115985/) | PchFET | SSM3J332RLF | 115985 | ¥120 | 1 | ¥120 | 10 | ¥12 | ¥24
20 | R1, R2, R5, R6, R10-R14 | 10kΩ | チップ抵抗 0603/1608 | 9 | チップ抵抗 1/10W10kΩ (https://akizukidenshi.com/catalog/g/g115029/) | 10kΩ | RC0603J10K | 115029 | ¥980 | 1 | ¥980 | 5000 | ¥1 | ¥9
21 | R3, R4, R7 | 33kΩ | カーボン抵抗 1/6w | 3 | カーボン抵抗(炭素皮膜抵抗) 1/6W33kΩ (https://akizukidenshi.com/catalog/g/g116333/) | 33kΩ | CF16J33KB | 116333 | ¥100 | 1 | ¥100 | 100 | ¥1 | ¥3
22 | R8 | 100Ω | カーボン抵抗 1/6w | 1 | カーボン抵抗(炭素皮膜抵抗) 1/6W100Ω (https://akizukidenshi.com/catalog/g/g116101/) | 100Ω | CF16J100RB | 116101 | ¥120 | 1 | ¥120 | 100 | ¥2 | ¥2
23 | R9 | 100kΩ | カーボン抵抗 1/6w | 1 | カーボン抵抗(炭素皮膜抵抗) 1/6W100kΩ (https://akizukidenshi.com/catalog/g/g116104/) | 100kΩ | RD16S 100K | 116104 | ¥100 | 1 | ¥100 | 100 | ¥1 | ¥1
24 | SP1 | SPEAKER | ターミナル 2端子 | 1 | ターミナルブロック 2P 青 縦 小 (https://akizukidenshi.com/catalog/g/g101306/) | 2端子 | TB111-2-2-U-1-1 | 101306 | ¥35 | 1 | ¥35 | 1 | ¥35 | ¥35
25 | SW1 | MENU | タクトスイッチ赤 | 1 | タクトスイッチ TVDP01-G73BB(赤) (https://akizukidenshi.com/catalog/g/g109825/) | Switch | TVDP01-G73BB with Red cap | 109825 | ¥20 | 1 | ¥20 | 1 | ¥20 | ¥20
26 | SW2 | UP | タクトスイッチ黒 | 1 | タクトスイッチ TVDP01-G73BB(黒) (https://akizukidenshi.com/catalog/g/g109824/) | Switch | TVDP01-G73BB with Black cap | 109824 | ¥20 | 1 | ¥20 | 1 | ¥20 | ¥20
27 | SW3 | DOWN | タクトスイッチ黒 | 1 | タクトスイッチ TVDP01-G73BB(黒) (https://akizukidenshi.com/catalog/g/g109824/) | Switch | TVDP01-G73BB with Black cap | 109824 | ¥20 | 1 | ¥20 | 1 | ¥20 | ¥20
28 | SW4 | RESET | 表面実装タクトスイッチ | 1 | 表面実装用タクトスイッチ TVAF06-A020B-R (https://akizukidenshi.com/catalog/g/g114888/) | Switch | TVAF06-A020B-R | 114888 | ¥110 | 1 | ¥110 | 5 | ¥22 | ¥22
29 | U1 | NJU72060 | オーディオアンプ | 1 | オーディオアンプIC NJU72060GM1T (https://akizukidenshi.com/catalog/g/g114330/) | Amp | NJU72060GM1T | 114330 | ¥90 | 1 | ¥90 | 1 | ¥90 | ¥90
30 | U2 | NJW4183U3-33B | レギュレータ 3.3v | 1 | 低損失レギュレーター 3.3V100mA NJW4183U3-33B (https://akizukidenshi.com/catalog/g/g113853/) | レギュレータ | NJW4183U3-33B | 113853 | ¥250 | 1 | ¥250 | 4 | ¥63 | ¥63
31 | U3 | KT0913 | ラジオIC | 1 | デジタルAM/FMレシーバー KT0913 (https://akizukidenshi.com/catalog/g/g117873/) | ラジオIC | KT0913 | 117873 | ¥150 | 1 | ¥150 | 1 | ¥150 | ¥150
32 | U4 | PIC16F18326 | PIC 14ピン | 1 | PICマイコン PIC16F18326-I/P (https://akizukidenshi.com/catalog/g/g111886/) | PIC | PIC16F18326-I/P | 111886 | ¥250 | 1 | ¥250 | 1 | ¥250 | ¥250
33 | U5 | AQM1602Y-FLW-FBW | LCDディスプレイ 16文字×2行 | 1 | LCDモジュール 16×2行 白色バックライト付 AQM1602Y-FLW-FBW (https://akizukidenshi.com/catalog/g/g112619/) | LCD | AQM1602Y-FLW-FBW | 112619 | ¥780 | 1 | ¥780 | 1 | ¥780 | ¥780
34 | Y1 | 32.78kHz | クリスタル VT200 | 1 | クリスタル(水晶発振子) 32.768kHz (https://akizukidenshi.com/catalog/g/g104005/) | クリスタル | VT-200-F 32.768kHz | 104005 | ¥30 | 1 | ¥30 | 1 | ¥30 | ¥30
35 |  | ジャンパーピン青(2.54mmピッチ) | ジャンパーピン青(2.54mmピッチ) | 1 | ジャンパーピン青(2.54mmピッチ) (https://akizukidenshi.com/catalog/g/g103690/) | ジャンパーピン | MJ-254-6BU | 103690 | ¥100 | 1 | ¥100 | 25 | ¥4 | ¥4
36 |  | SPEAKER | スピーカー 5cm | 1 | スピーカーユニット 5cm 8Ω0.5W (https://akizukidenshi.com/catalog/g/g116024/) | 8Ω 0.5w | DXYD50N-22Z-8A-F | 116024 | ¥180 | 1 | ¥180 | 1 | ¥180 | ¥180
37 |  | BATTERY | 電池ボックス 単3×4本 | 1 | 電池ボックス 単3×4本 リード線 (https://akizukidenshi.com/catalog/g/g102671/) | 電池ボックス | BH-341-2A150MM | 102671 | ¥80 | 1 | ¥80 | 1 | ¥80 | ¥80
38 |  | 基板 | 基板 | 1 | プリント基板 |  |  |  | ¥500 | 1 | ¥500 | 1 | ¥500 | ¥500
 |  |  |  |  |  |  |  |  |  |  |  |  | 合計 | ¥2451
