PlanetxGear/KT0913_FM_Radio/20240402_KT0913_FM_Radio_回路図.pdf

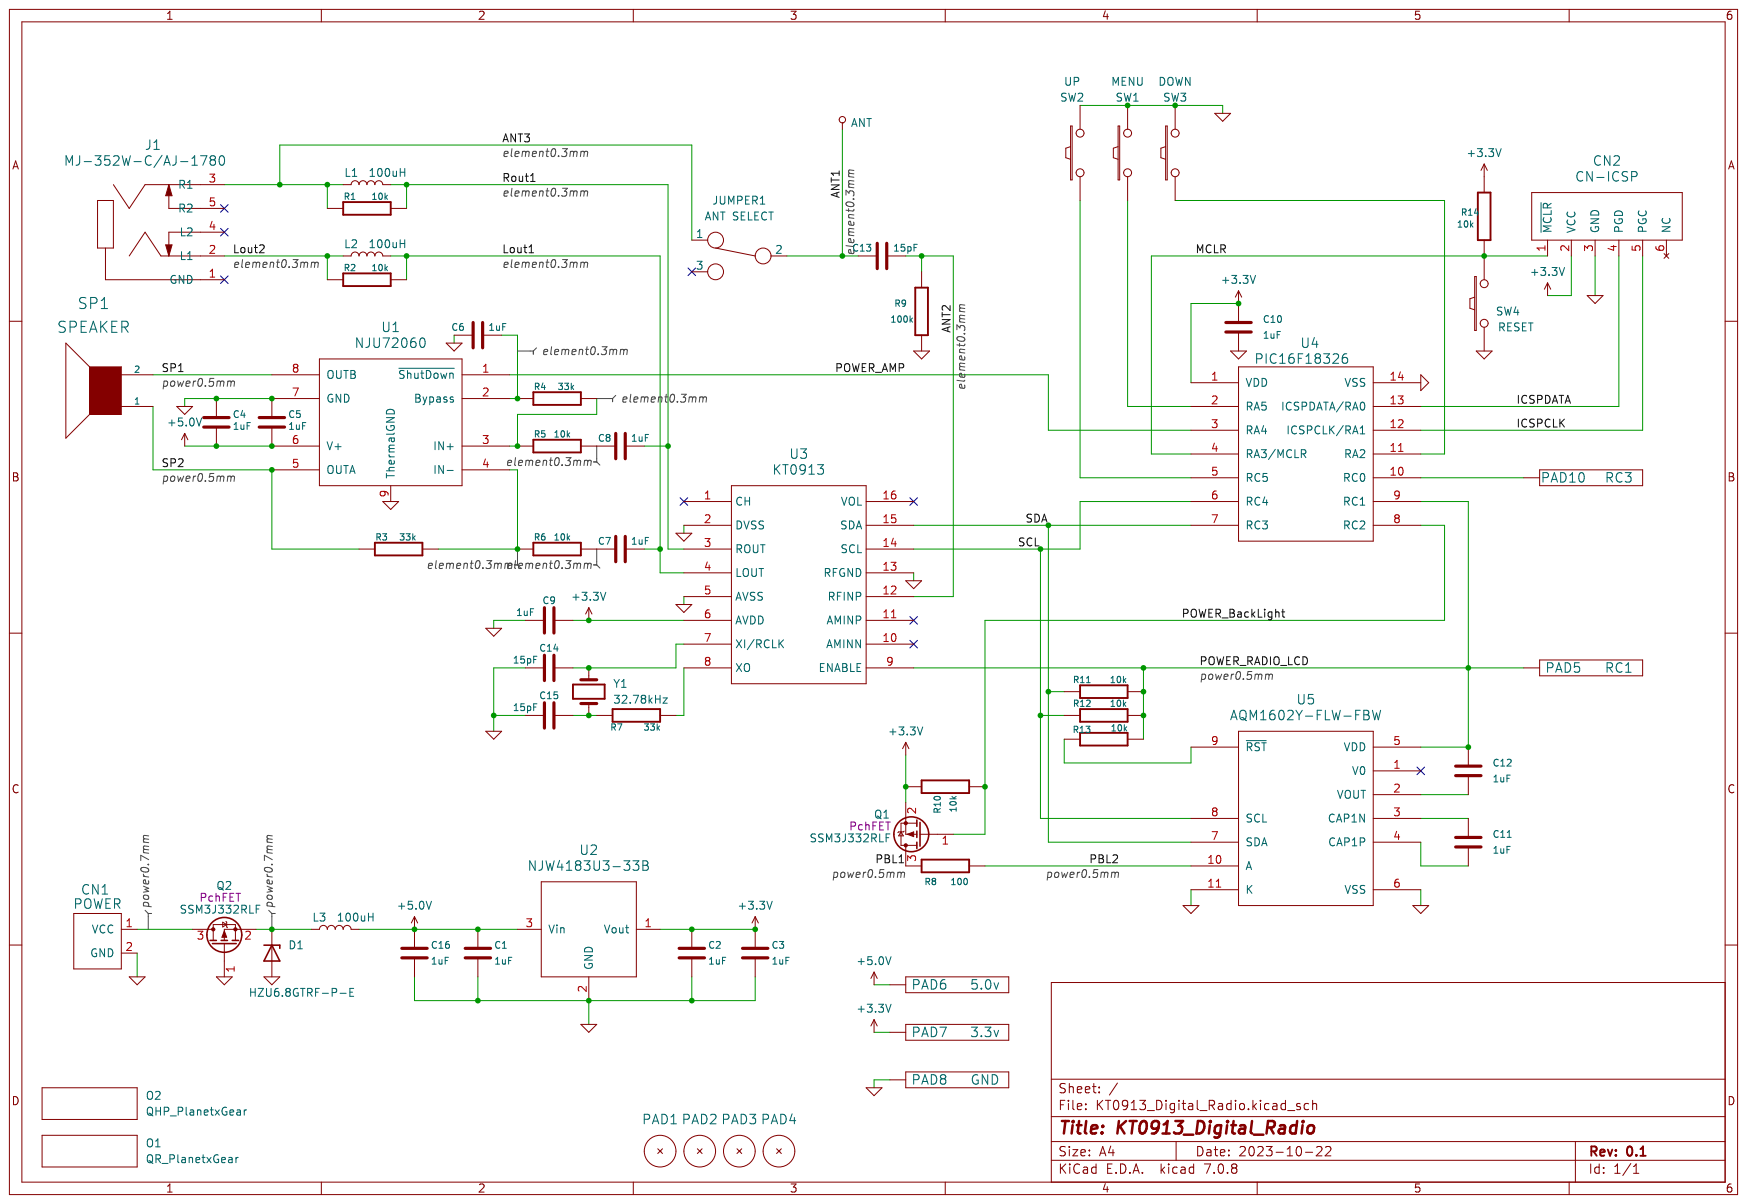
[picture p26: page 1]
