PlanetxGear/KT0913_FM_Radio/20240402_KT0913_FM_Radio_基板寸法.pdf

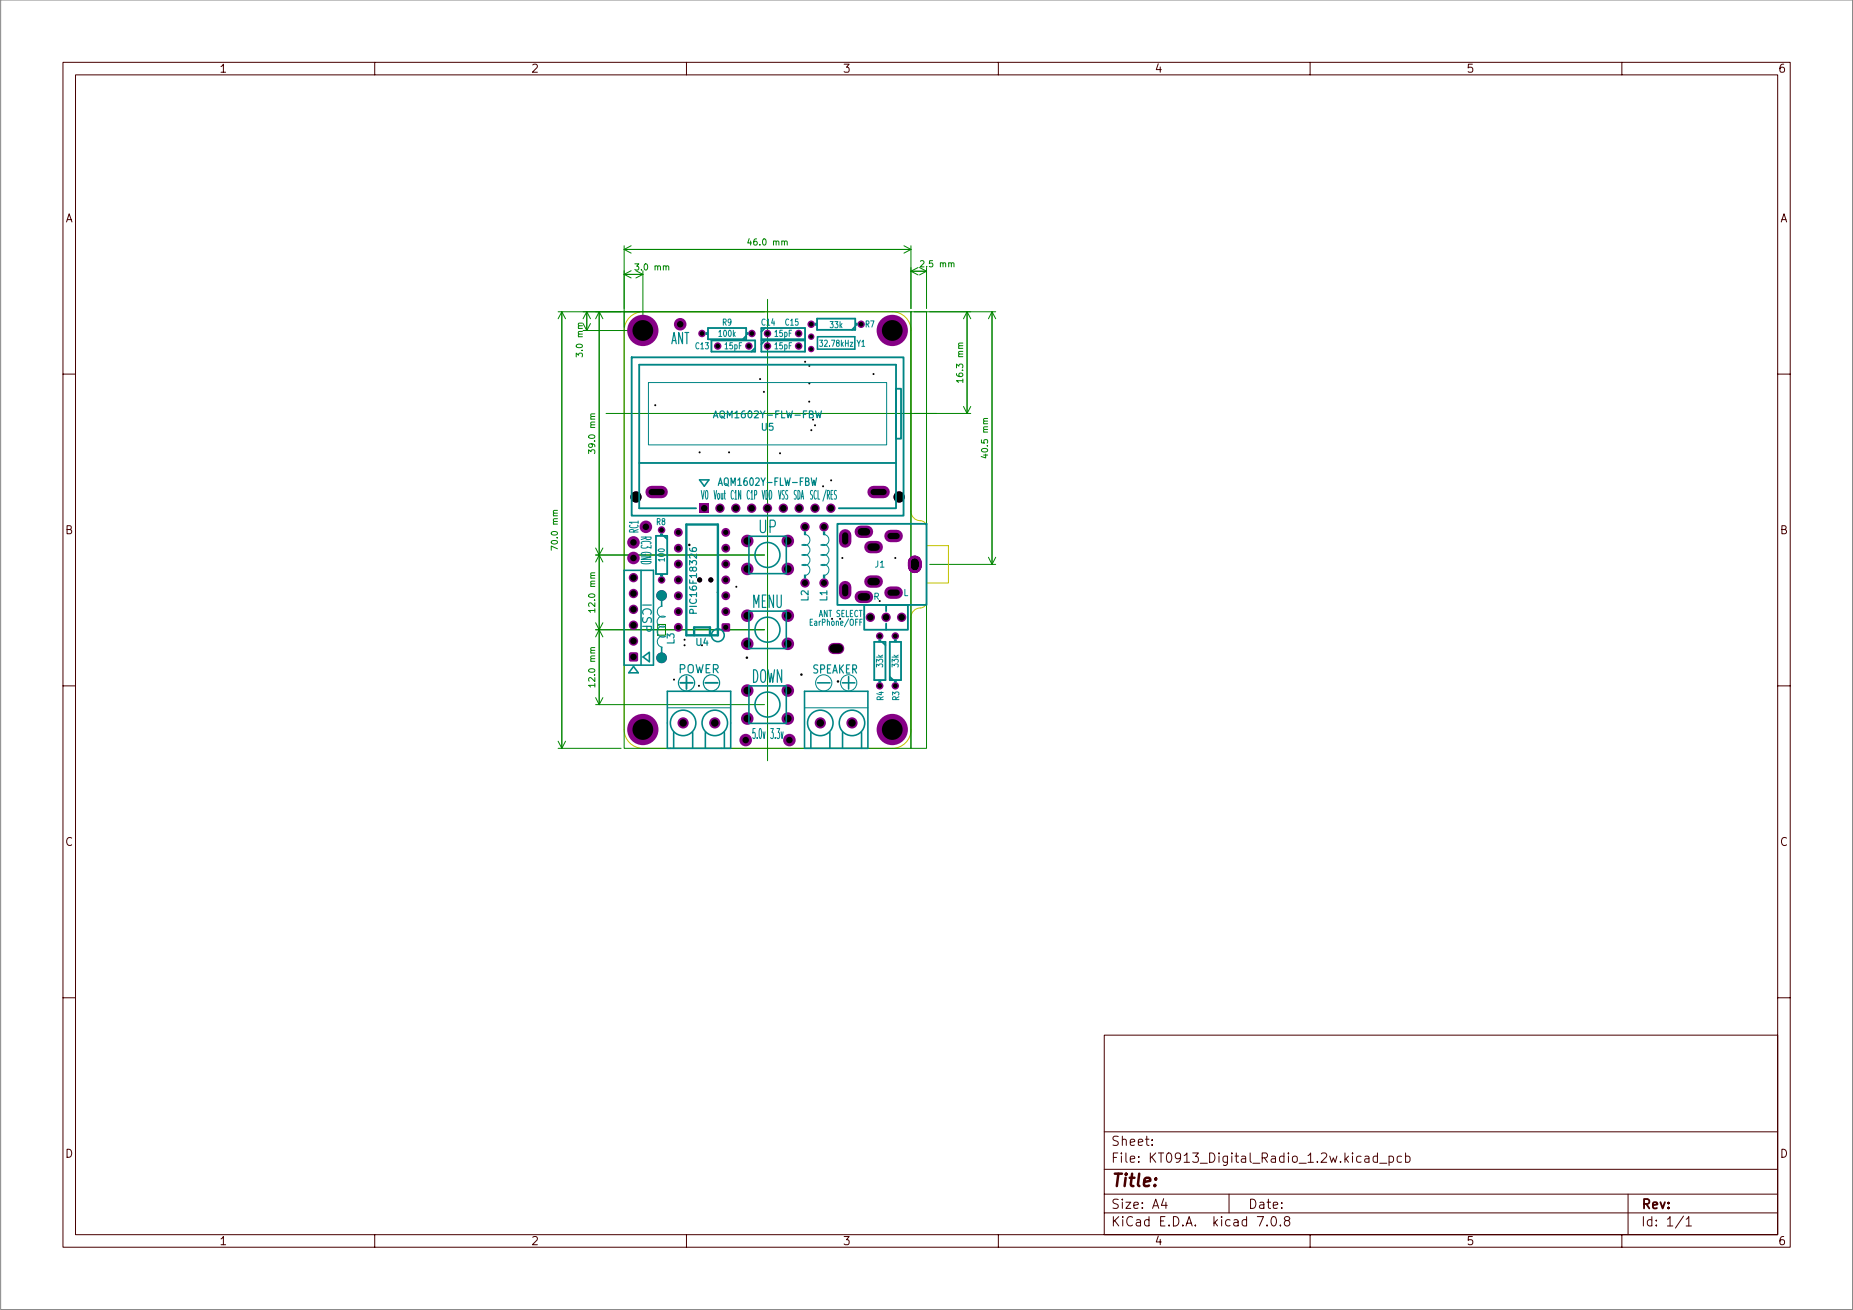
[picture p27: page 1]
