PlanetxGear/KT0913_FM_Radio/LTSpice/Filter_001.asc

C1: cap; 0.1uF
C2: cap; 10pF
L1: ind; 1uH; Ipk=2 Rser=0.062 Rpar=16900 Cpar=2.23p
R2: res; 100k
V1: voltage; ""; AC 0.001
Named nets: 0, Vin, Vout, Vout2
.ac oct 10 100 1000Meg
