PlanetxGear/KT0913_FM_Radio/KICAD/KT0913_Digital_Radio/KT0913_Digital_Radio.kicad_pcb

## KiCad design KICAD/KT0913_Digital_Radio/KT0913_Digital_Radio.kicad_pcb (2024-04-03)

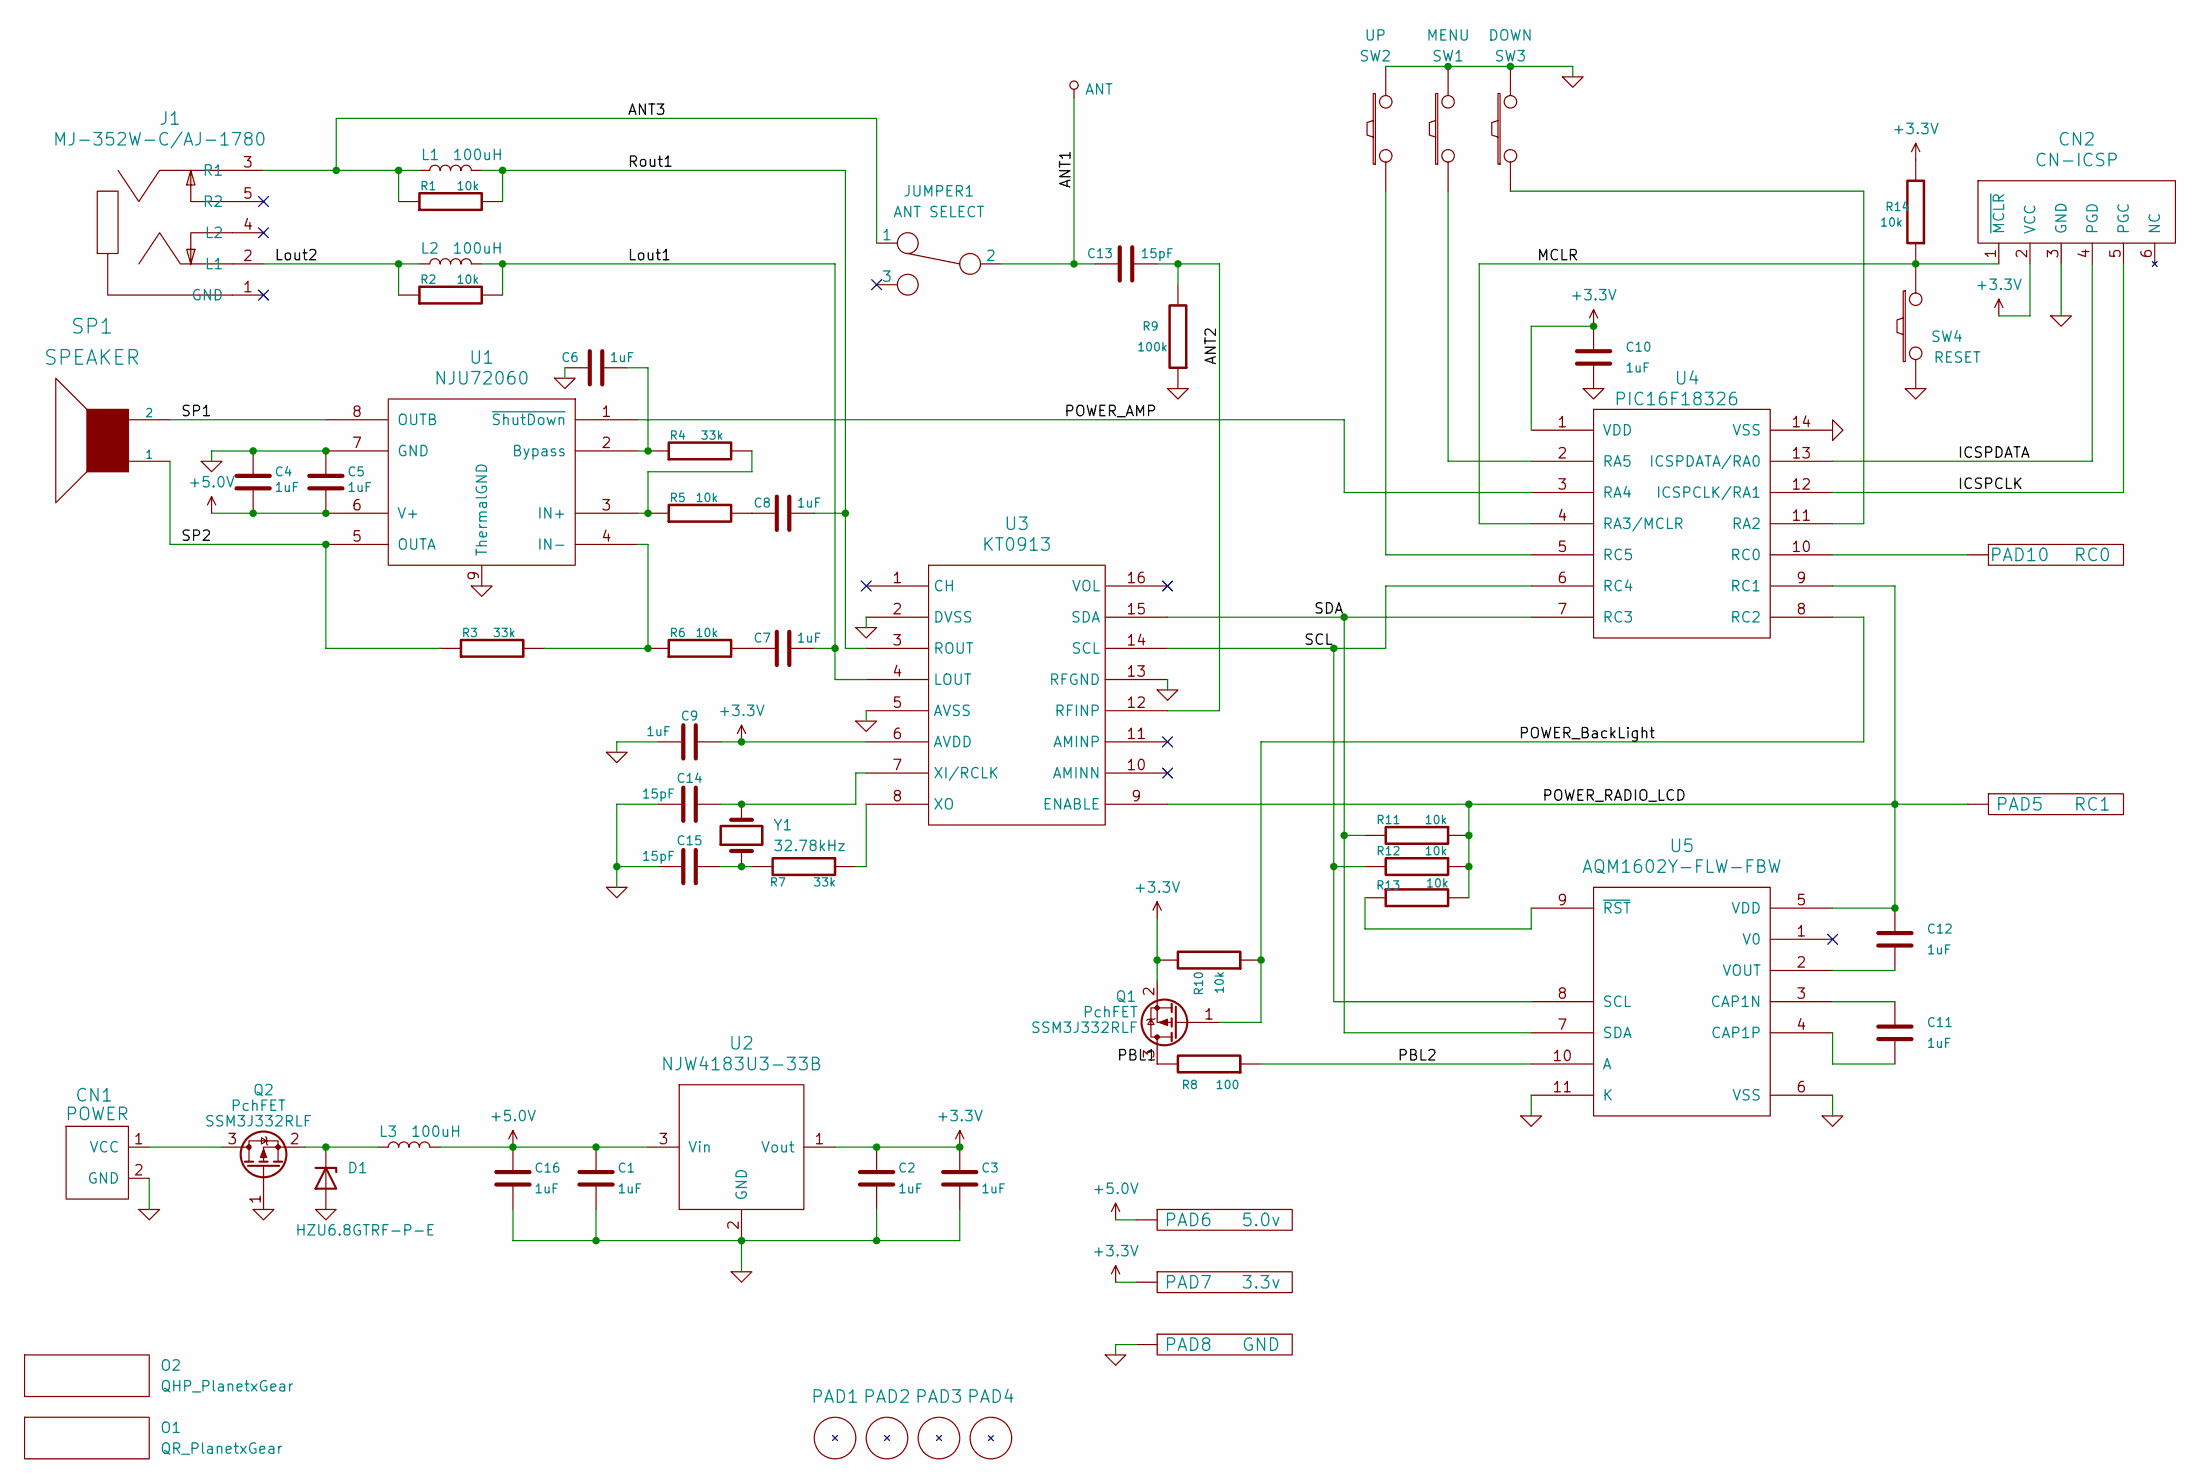
[picture p28: schematic KT0913_Digital_Radio.kicad_sch]

Parts:
ANT1: ANT; PAD1mmX2m
C1, C2, C3, C4, C5, C6, C7, C8, C9, C10, C11, C12, C16: 1uF; SMD_0603_1608_MU_HandSolder
C13, C14, C15: 15pF; C2_MU5mm
CN1: POWER; TERMINAL_2P_POWER
CN2: CN-ICSP; PINHEAD1-PICkit_ICSP_Tin
D1: HZU6.8GTRF-P-E; SC-76A
J1: MJ-352W-C/AJ-1780; JACK_EarPhone_MJ-352W-C_R
JUMPER1: ANT SELECT; JUMPER1-3
L1, L2: 100uH; L4_MU9mm
L3: 100uH; L4_MU10mm
O1: QR_PlanetxGear
O2: QHP_PlanetxGear
PAD1, PAD2, PAD3, PAD4: PAD; PAD3mmX5mm
PAD5: RC1; PAD1mmX2m
PAD6: 5.0v; PAD1mmX2m
PAD7: 3.3v; PAD1mmX2m
PAD8: GND; PAD1mmX2m
PAD10: RC0; PAD1mmX2m
Q1, Q2: SSM3J332RLF; SOT-23-3_MU_Handsoldering
R1, R2, R5, R6, R10, R11, R12, R13, R14: 10k; SMD_0603_1608_MU_HandSolder
R3, R4, R7: 33k; R4_MU8mm
R8: 100; R4_MU8mm
R9: 100k; R4_MU8mm
SP1: SPEAKER; TERMINAL_2P
SW1: MENU; SW_PUSH-6mm_AK
SW2: UP; SW_PUSH-6mm_AK
SW3: DOWN; SW_PUSH-6mm_AK
SW4: RESET; SW_PUSH_TVAF06-A020B-R
U1: NJU72060; SOP-8_6x5mm_P1.27mm_EP3.0x4.4mm_ThermalVias
U2: NJW4183U3-33B; SOT-89-3_MU_Handsoldering
U3: KT0913; SSOP-16_MU_3.9x4.9mm_P0.635mm
U4: PIC16F18326; DIP-14_300_MU
U5: AQM1602Y-FLW-FBW; LCD_AQM1602Y-FLW-FBW
Y1: 32.78kHz; X_TAL_VT200

Connections:
+3.3V: C2.1, C3.1, C9.2, C10.1, CN2.2 (VCC), PAD7.1, Q1.2 (S), R10.2, R14.2, U2.1 (Vout), U3.6 (AVDD), U4.1 (VDD)
+5.0V: C1.1, C4.2, C5.2, C16.1, L3.2, PAD6.1, U1.6 (V+), U2.3 (Vin)
/ANT1: ANT1.1 (ANT), C13.2, JUMPER1.2
/ANT2: C13.1, R9.2, U3.12 (RFINP)
/ANT3: J1.3 (R1), JUMPER1.1, L1.1, R1.1
/ICSPCLK: CN2.5 (PGC), U4.12 (ICSPCLK/RA1)
/ICSPDATA: CN2.4 (PGD), U4.13 (ICSPDATA/RA0)
/Lout1: C7.1, L2.2, R2.2, U3.4 (LOUT)
/Lout2: J1.2 (L1), L2.1, R2.1
/MCLR: CN2.1 (~MCLR), R14.1, SW4.1, U4.4 (RA3/MCLR)
/PBL1: Q1.3 (D), R8.2
/PBL2: R8.1, U5.10 (A)
/POWER_AMP: U1.1 (~ShutDown), U4.3 (RA4)
/POWER_BackLight: Q1.1 (G), R10.1, U4.8 (RC2)
/POWER_RADIO_LCD: C12.1, PAD5.1, R11.1, R12.1, R13.2, U3.9 (ENABLE), U4.9 (RC1), U5.5 (VDD)
/Rout1: C8.1, L1.2, R1.2, U3.3 (ROUT)
/SCL: R12.2, U3.14 (SCL), U4.6 (RC4), U5.8 (SCL)
/SDA: R11.2, U3.15 (SDA), U4.7 (RC3), U5.7 (SDA)
/SP1: SP1.2, U1.8 (OUTB)
/SP2: R3.1, SP1.1, U1.5 (OUTA)
GND: C1.2, C2.2, C3.2, C4.1, C5.1, C6.2, C9.1, C10.2, C14.1, C15.1, C16.2, CN1.2 (GND), CN2.3 (GND), D1.2 (A), PAD8.1, Q2.1 (G), R9.1, SW1.2, SW2.2, SW3.2, SW4.2, U1.7 (GND), U1.9 (ThermalGND), U2.2 (GND), U3.2 (DVSS), U3.5 (AVSS), U3.13 (RFGND), U4.14 (VSS), U5.6 (VSS), U5.11 (K)
unnamed: C7.2, R6.2
unnamed: C8.2, R5.2
unnamed: C15.2, R7.2, Y1.1
unnamed: CN1.1 (VCC), Q2.3 (D)
unnamed: D1.1 (K), L3.1, Q2.2 (S)
unnamed: PAD10.1, U4.10 (RC0)
unnamed: C6.1, R4.1, U1.2 (Bypass)
unnamed: R4.2, R5.1, U1.3 (IN+)
unnamed: R3.2, R6.1, U1.4 (IN-)
unnamed: C14.2, U3.7 (XI/RCLK), Y1.2
unnamed: R7.1, U3.8 (XO)
unnamed: SW3.1, U4.11 (RA2)
unnamed: SW1.1, U4.2 (RA5)
unnamed: SW2.1, U4.5 (RC5)
unnamed: C11.1, U5.3 (CAP1N)
unnamed: C11.2, U5.4 (CAP1P)
unnamed: C12.2, U5.2 (VOUT)
unnamed: R13.1, U5.9 (~RST)

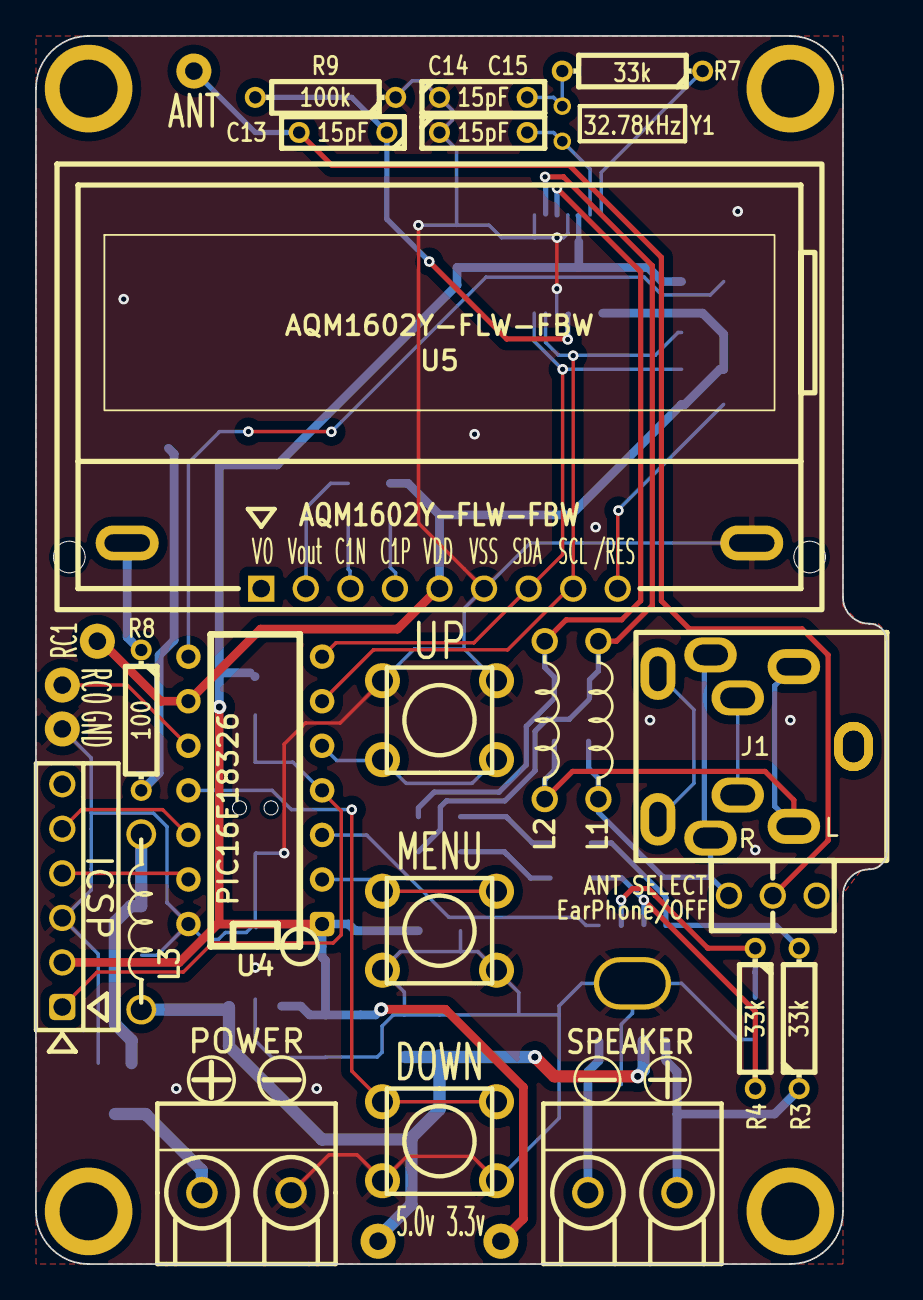
[picture p29: board KT0913_Digital_Radio.kicad_pcb from above]

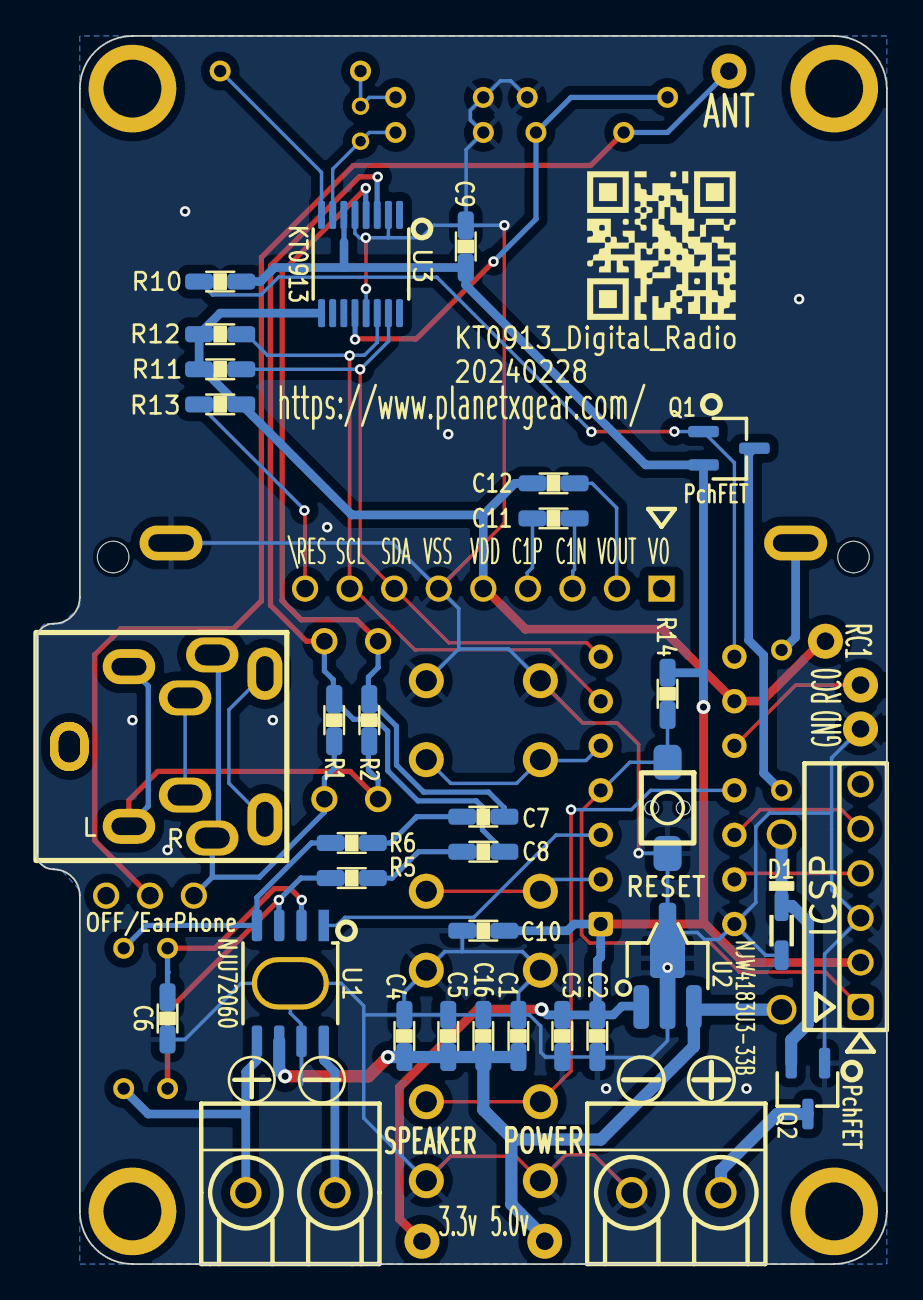
[picture p30: board KT0913_Digital_Radio.kicad_pcb from below]

Board: 2 copper layers, 48.5 x 70.0 mm, 63 parts (32 on the bottom side), 39 nets.
